AmazingSpanoMan/Gremlin_Gamepad/Gremlin_v3/CAD_Files/switch-joycon-joystick-1/Switch JoyCon joystick.jpg

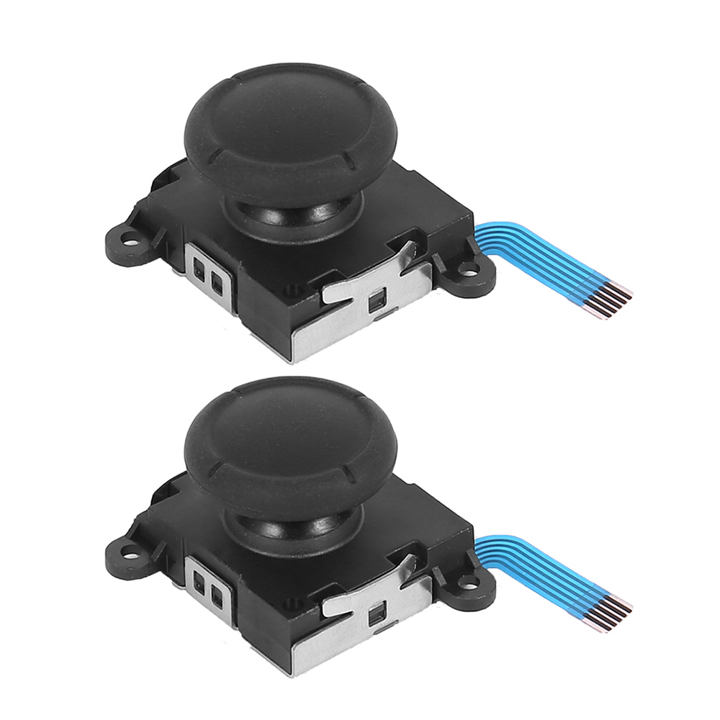
Gremlin_v3/CAD_Files/switch-joycon-joystick-1/Switch JoyCon joystick.jpg
