AmazingSpanoMan/Gremlin_Gamepad/Gremlin_v3/KiCad/Gemini_Generated_Image_chgj80chgj80chgj.jpg

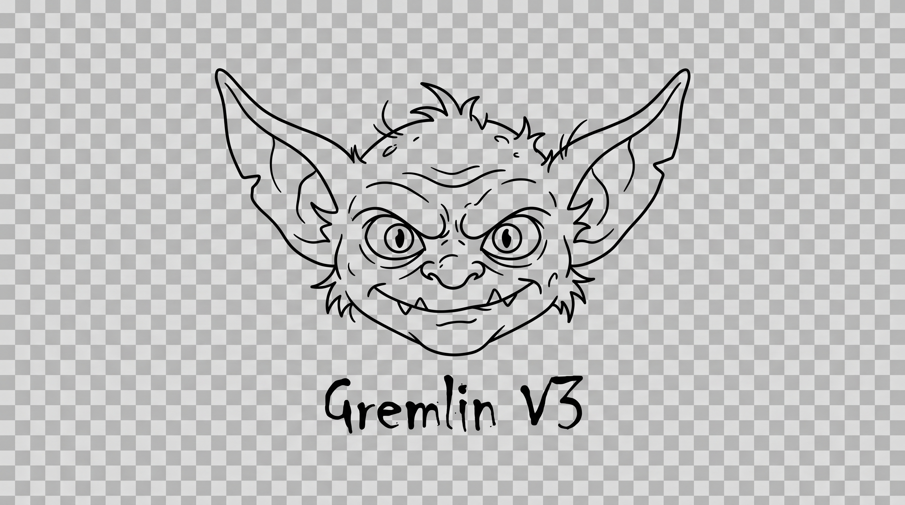
Gremlin_v3/KiCad/Gemini_Generated_Image_chgj80chgj80chgj.jpg
