AmazingSpanoMan/Gremlin_Gamepad/Gremlin_v3/KiCad/Gremlin_v3/production/bom.csv

Designator | Footprint | Quantity | Value | LCSC Part #
D1, D10, D11, D12, D13, D14, D15, D16, D17, D18, D19, D2, D20, D21, D22, D3, D4, D5, D6, D7, D8, D9 | Diode_SOD-123 | 22 | Diode
J1 | JST_EH_S2B-EH_1x02_P2.50mm_Horizontal | 1 | JST_02
J2 | CONN_503480-0540_MOL | 1 | 5034800540
S1, S10, S11, S12, S13, S14, S15, S16, S17, S18, S19, S2, S20, S21, S22, S3, S4, S5, S6, S7, S8, S9 | Hotswap_Choc_V1 | 22 | Keyswitch
SW1 | Panasonic_EVQPUJ_EVQPUA | 1 | Switch
SW2 | SW_SPDT_PCM12 | 1 | SW_SPST
U1 | Nice_Nano_V2 | 1 | Nice_Nano_V2
