AmazingSpanoMan/Gremlin_Gamepad/Gremlin_v3/CAD_Files/ScottoCaps/Flat/Blanks/2.75u.step

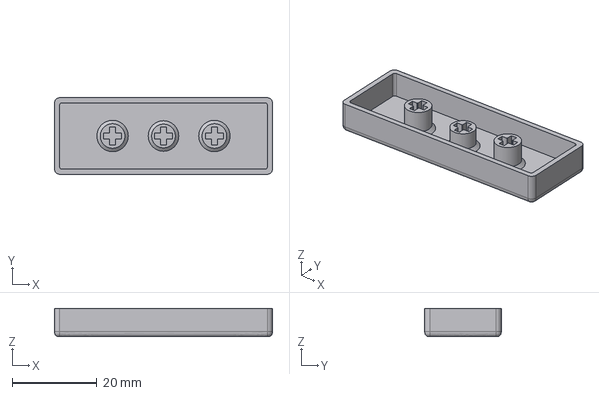
[picture p4: CAD file, 2026-10-09]
Gremlin_v3/CAD_Files/ScottoCaps/Flat/Blanks/2.75u.step
51.4 x 18.0 x 6.70 mm
