AmazingSpanoMan/Gremlin_Gamepad/Gremlin_v3/CAD_Files/ScottoCaps/Flat/Legends/Y.3mf

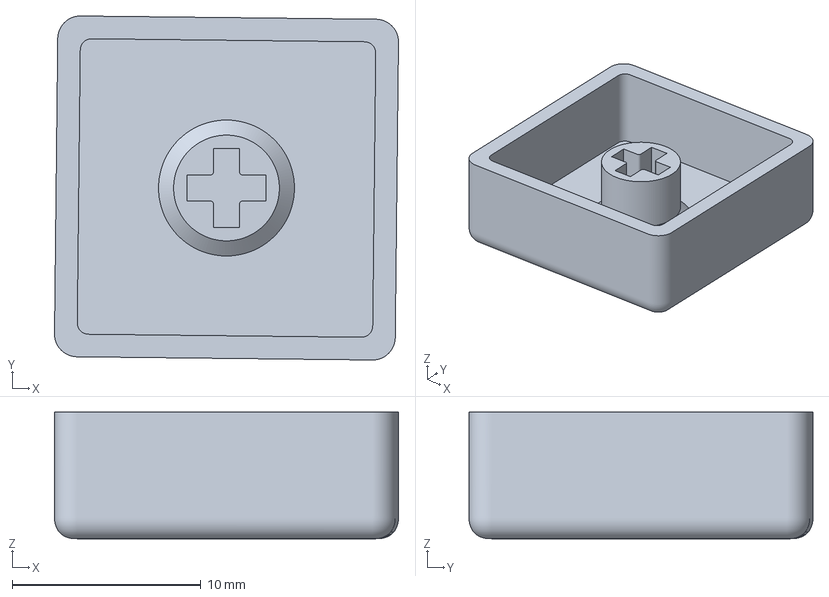
[picture p5: CAD file, 2026-10-09]
Gremlin_v3/CAD_Files/ScottoCaps/Flat/Legends/Y.3mf
18.2 x 18.2 x 6.70 mm
Y_Keycap
Y_Text
