AmazingSpanoMan/Gremlin_Gamepad/Gremlin_v3/CAD_Files/ScottoCaps/Flat/ScottoCaps (Flat).step

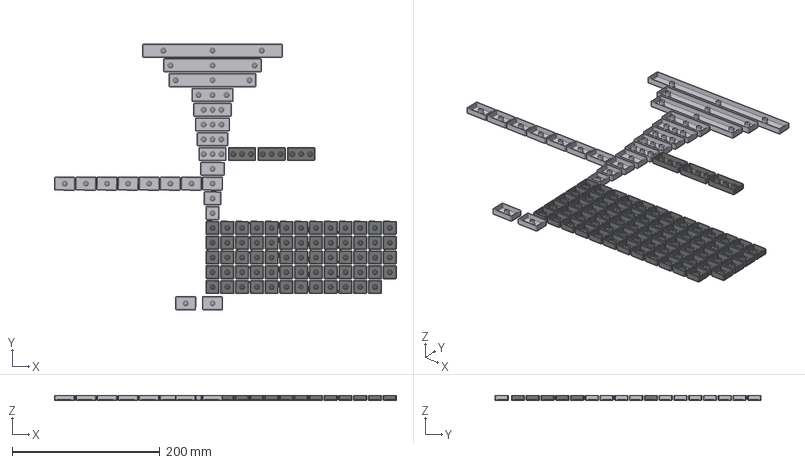
[picture p6: CAD file, 2026-10-09]
Gremlin_v3/CAD_Files/ScottoCaps/Flat/ScottoCaps (Flat).step
463.0 x 360.2 x 6.70 mm
Windows (1.50u)
Delete (1.50u)
Tab (1.50u)
Shift (1.50u)
Control (1.50u)
Alt (1.50u)
Caps Lock (1.50u)
No (1.50u)
Yes (1.50u)
Tilde
0 (2.00u)
Backspace
Tab
Q
W
F
P
G
J
L
U
Y
Semicolon
Slash
FSlash
Enter
Enter (2.00u)
A
R
S
T
D
H
N
E
I
O
Quote
LShift
Z
X
C
V
B
K
M
Less
Greater
Question
RShift
Hexagon1
Triangle1
Circle1
Square1
Hexagon2
Triangle2
Circle2
Square2
Left
Up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
