AmazingSpanoMan/Gremlin_Gamepad/Gremlin_v3/CAD_Files/ScottoCaps/Scooped/Choc/Blanks/16x16/1.25u (16x16 - Concave).step

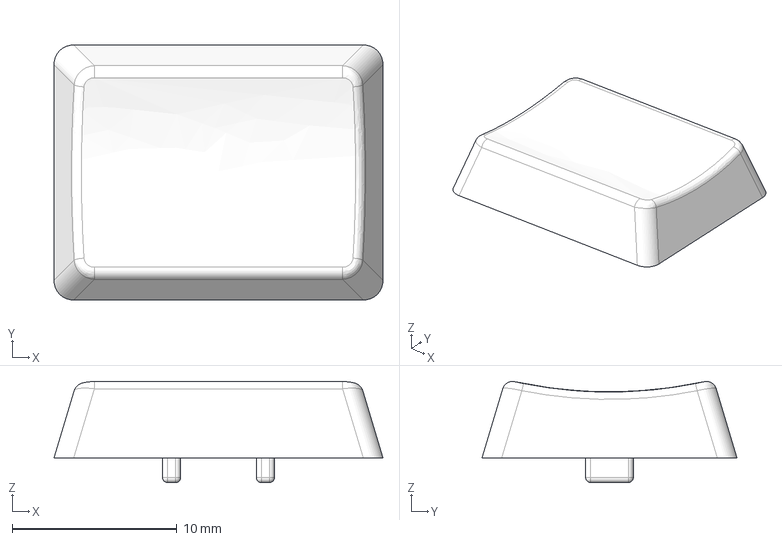
[picture p9: CAD file, 2026-10-09]
Gremlin_v3/CAD_Files/ScottoCaps/Scooped/Choc/Blanks/16x16/1.25u (16x16 - Concave).step
20.0 x 15.5 x 6.14 mm
