AmazingSpanoMan/Gremlin_Gamepad/Gremlin_v3/CAD_Files/ScottoCaps/Scooped/Choc/Blanks/18x17/1.75u (18x17 - Concave).step

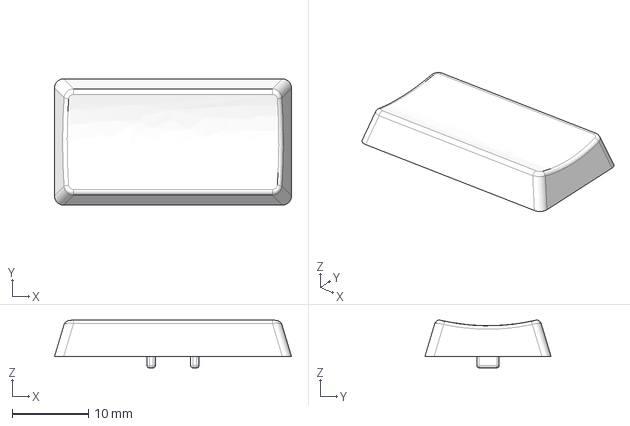
[picture p10: CAD file, 2026-10-09]
Gremlin_v3/CAD_Files/ScottoCaps/Scooped/Choc/Blanks/18x17/1.75u (18x17 - Concave).step
31.0 x 16.5 x 6.25 mm
