AmazingSpanoMan/Gremlin_Gamepad/Gremlin_v3/CAD_Files/ScottoCaps/Scooped/MX/Alphas.3mf

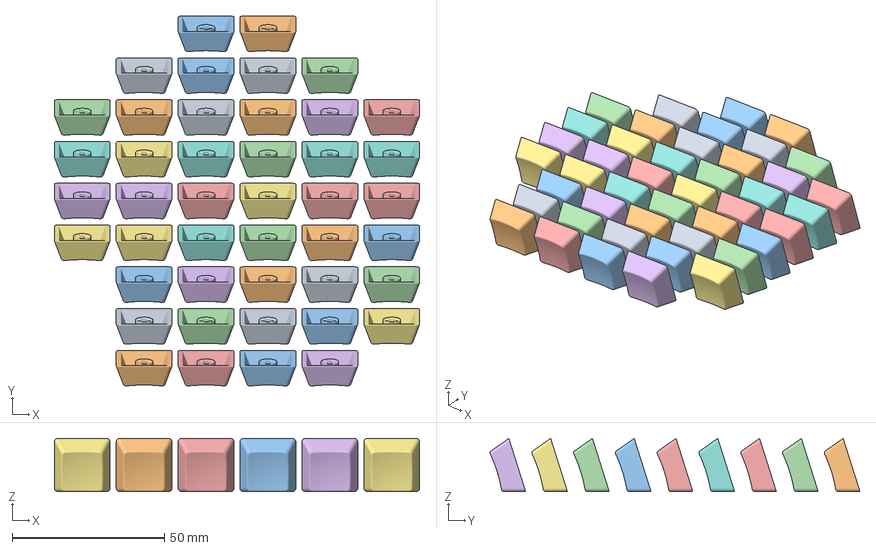
[picture p15: CAD file, 2026-10-09]
Gremlin_v3/CAD_Files/ScottoCaps/Scooped/MX/Alphas.3mf
119.8 x 121.3 x 17.5 mm
0 (1.00u)
Tilde
K
V
Angle Bracket x 2
D
O
Z
E
I
C
M
F (Homing Bar)
X
R
Y
J
S
B
U
P
N
F
H
Q
T
N (Homing Bar)
J (Homing Bar)
T (Homing Bar)
G
L
Question Mark
A
W
