AmazingSpanoMan/Gremlin_Gamepad/Gremlin_v3/CAD_Files/ScottoCaps/Scooped/MX/Blanks/2.75u (Concave).step

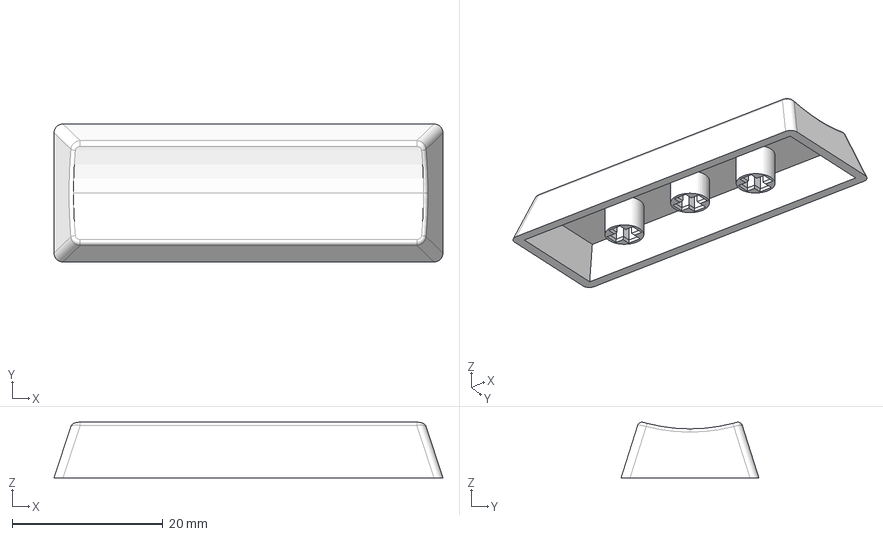
[picture p16: CAD file, 2026-10-09]
Gremlin_v3/CAD_Files/ScottoCaps/Scooped/MX/Blanks/2.75u (Concave).step
51.6 x 18.3 x 7.39 mm
