AmazingSpanoMan/Gremlin_Gamepad/Gremlin_v3/CAD_Files/ScottoCaps/Scooped/MX/Legends/Enter (1.00u).3mf

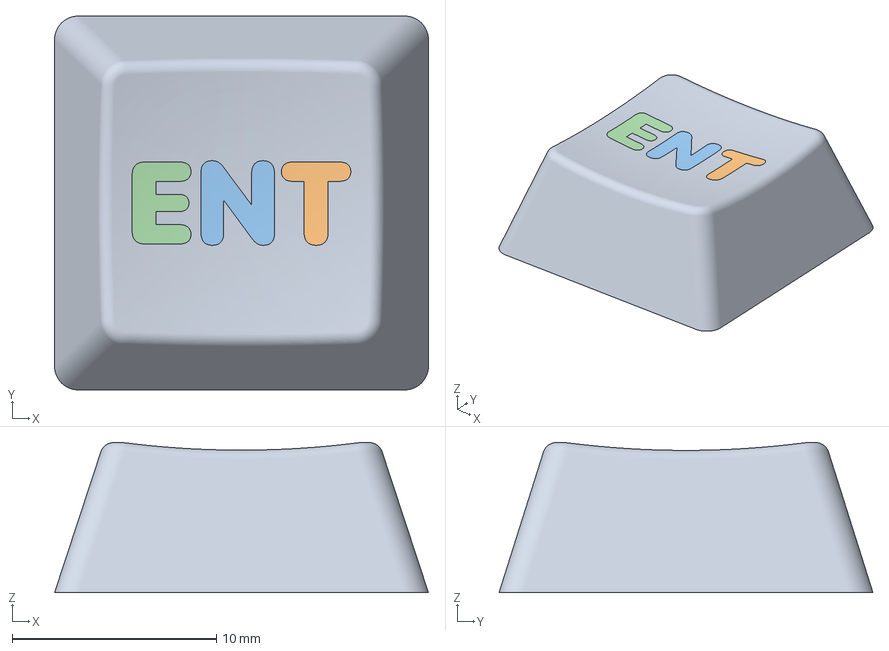
[picture p17: CAD file, 2026-10-09]
Gremlin_v3/CAD_Files/ScottoCaps/Scooped/MX/Legends/Enter (1.00u).3mf
18.3 x 18.3 x 7.36 mm
Keycap
T
N
E
