AmazingSpanoMan/Gremlin_Gamepad/Gremlin_v3/CAD_Files/ScottoCaps/Scooped/MX/Raw/Concave Cutter.step

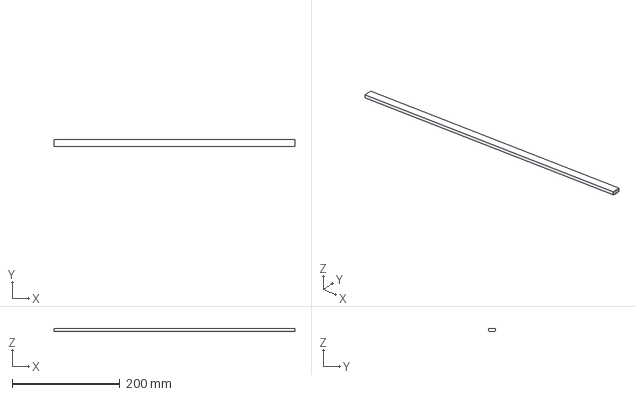
[picture p18: CAD file, 2026-10-09]
Gremlin_v3/CAD_Files/ScottoCaps/Scooped/MX/Raw/Concave Cutter.step
446.9 x 13.3 x 6.00 mm
