AmazingSpanoMan/Gremlin_Gamepad/Gremlin_v3/CAD_Files/ScottoCaps/Sculpted/Blanks/R3 - 2.00u.step

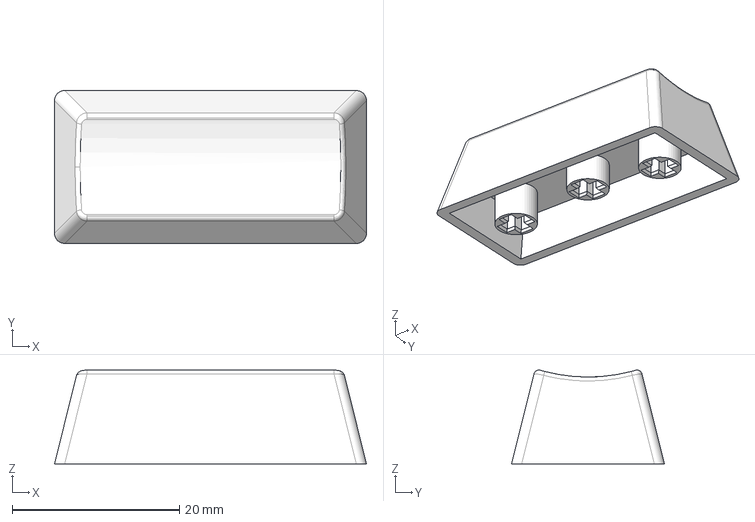
[picture p19: CAD file, 2026-10-09]
Gremlin_v3/CAD_Files/ScottoCaps/Sculpted/Blanks/R3 - 2.00u.step
37.4 x 18.3 x 11.2 mm
