AmazingSpanoMan/Gremlin_Gamepad/Gremlin_v3/CAD_Files/STL/Power Switch Button.stl

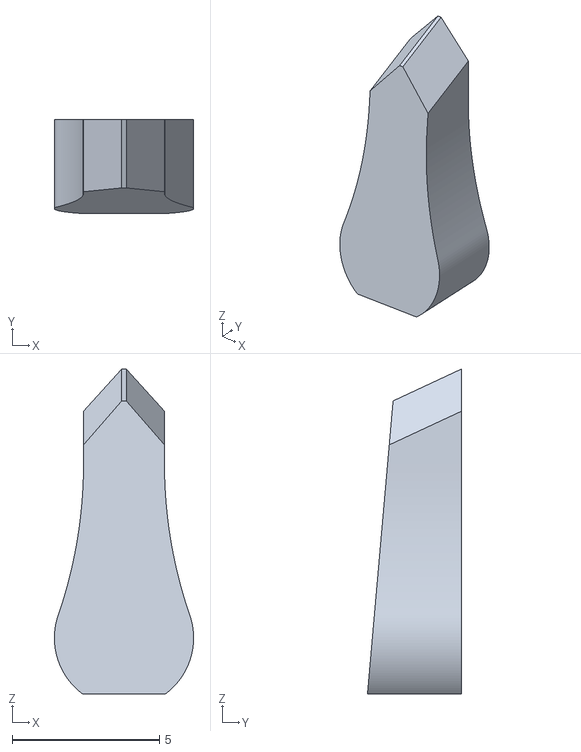
[picture p20: CAD file, 2026-11-13]
Gremlin_v3/CAD_Files/STL/Power Switch Button.stl
4.73 x 3.20 x 11.1
