AmazingSpanoMan/Gremlin_Gamepad/Gremlin_v3/CAD_Files/switch-joycon-joystick-1/Switch JoyCon joystick v2.step

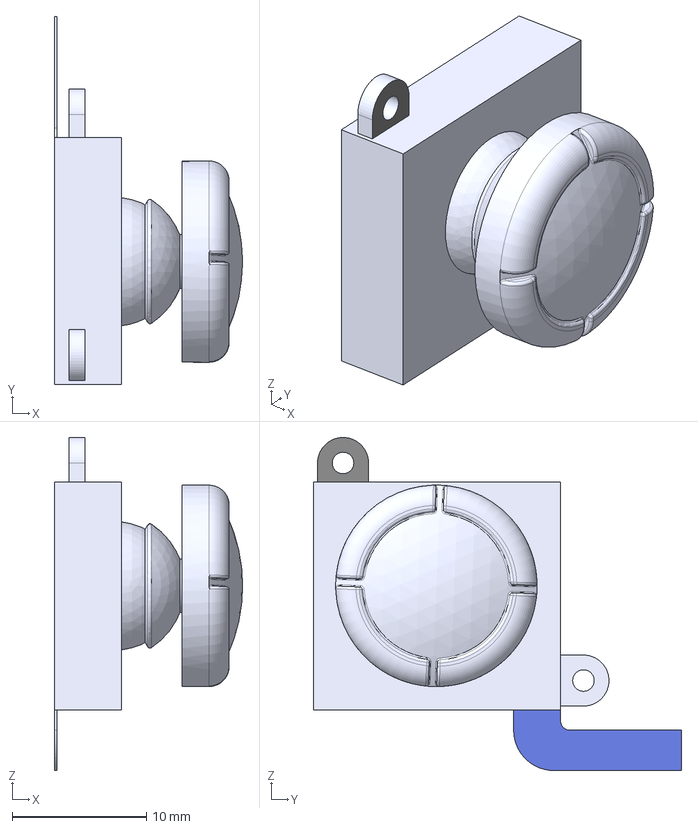
[picture p21: CAD file, 2026-10-09]
Gremlin_v3/CAD_Files/switch-joycon-joystick-1/Switch JoyCon joystick v2.step
14.0 x 27.4 x 24.8 mm
