AmazingSpanoMan/Gremlin_Gamepad/Gremlin_v3/KiCad/Footprint models/FPC-5.stp

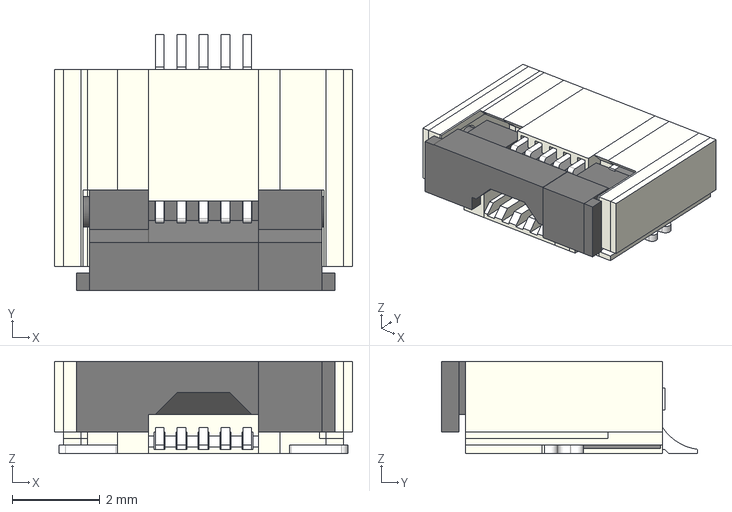
[picture p22: CAD file, 2026-10-09]
Gremlin_v3/KiCad/Footprint models/FPC-5.stp
6.80 x 5.85 x 2.11 mm
