AmazingSpanoMan/Gremlin_Gamepad/Gremlin_v3/KiCad/Gremlin_v3/Gremlin_v3_3.step

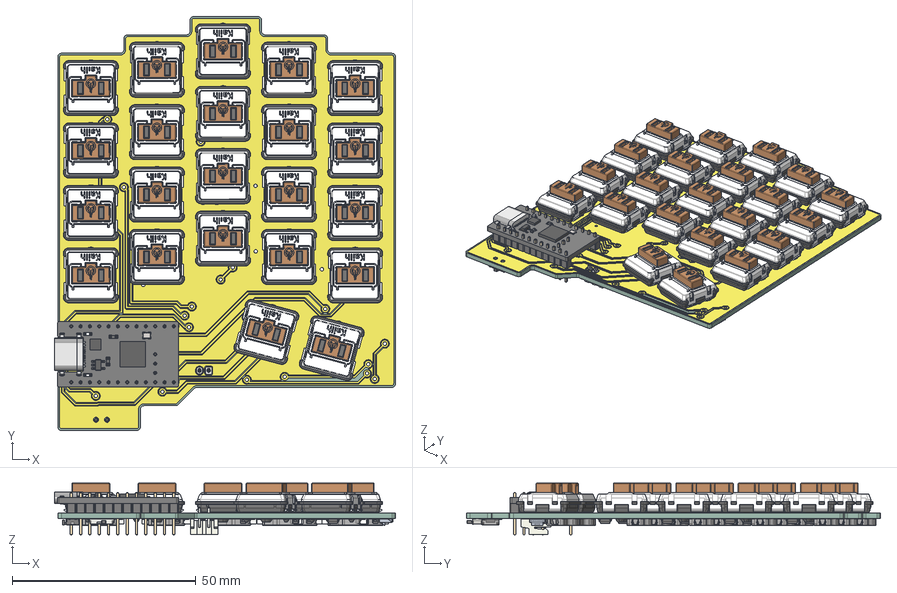
[picture p23: CAD file, 2026-10-23]
Gremlin_v3/KiCad/Gremlin_v3/Gremlin_v3_3.step
92.9 x 112.8 x 14.1 mm
SW_Hotswap_Kailh_Choc_v1 x 22
SW_Kailh_Choc_V1_cp x 22
PinHeader_1x12_P2.54mm_Vertical.step
User Library-TYPE-C-31-M-14.step
MICRO_603 resistor 102
MICRO_stackable header pin x 12
MICRO_stackable header 12
micro_crystal 5x3
MICRO_led
micro_MIC5219
D_SOD_123 x 22
Panasonic_EVQPUJ_EVQPUA
Fusion_sp
JST_S2B_EH
Gremlin_v3_copper
Gremlin_v3_pad
Gremlin_v3_via
Gremlin_v3_PCB
