AmazingSpanoMan/Gremlin_Gamepad/Gremlin_v3/CAD_Files/ScottoCaps/Flat/Blanks/2.00u.step

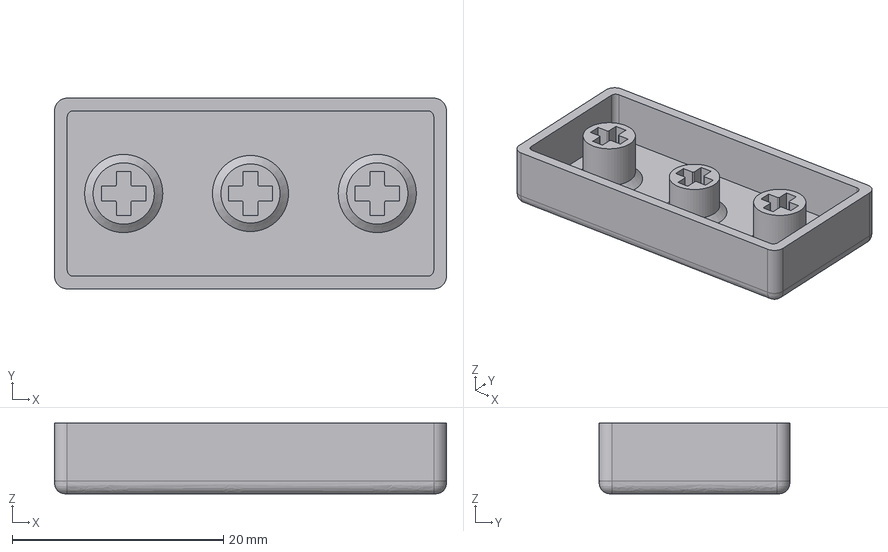
[picture p24: CAD file, 2026-10-09]
Gremlin_v3/CAD_Files/ScottoCaps/Flat/Blanks/2.00u.step
37.1 x 18.0 x 6.70 mm
