AmazingSpanoMan/Gremlin_Gamepad/Gremlin_v3/CAD_Files/ScottoCaps/Flat/Legends/Alt (1.50u).3mf

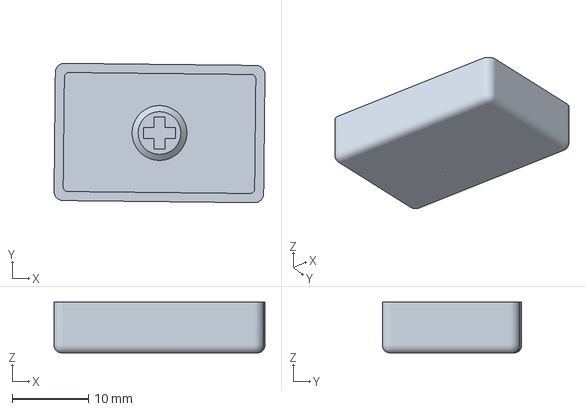
[picture p25: CAD file, 2026-10-09]
Gremlin_v3/CAD_Files/ScottoCaps/Flat/Legends/Alt (1.50u).3mf
27.7 x 18.3 x 6.70 mm
