AmazingSpanoMan/Gremlin_Gamepad/Gremlin_v3/CAD_Files/ScottoCaps/Glass/MX/ScottoCaps (Glass) - 2.00u.step

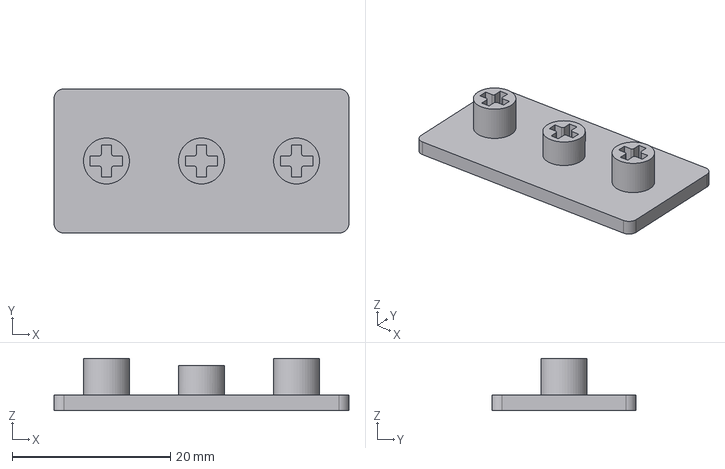
[picture p27: CAD file, 2026-10-09]
Gremlin_v3/CAD_Files/ScottoCaps/Glass/MX/ScottoCaps (Glass) - 2.00u.step
37.2 x 18.2 x 6.60 mm
