AmazingSpanoMan/Gremlin_Gamepad/Gremlin_v3/CAD_Files/ScottoCaps/Scooped/Choc/Blanks/16x16/1.50u (16x16 - Concave).step

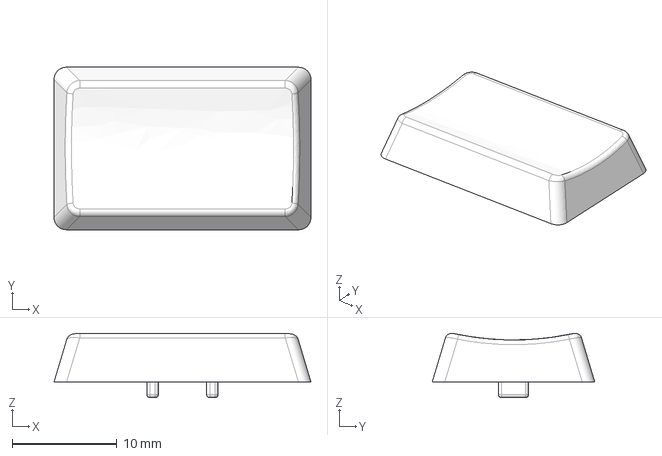
[picture p28: CAD file, 2026-10-09]
Gremlin_v3/CAD_Files/ScottoCaps/Scooped/Choc/Blanks/16x16/1.50u (16x16 - Concave).step
24.5 x 15.5 x 6.14 mm
