AmazingSpanoMan/Gremlin_Gamepad/Gremlin_v3/CAD_Files/ScottoCaps/Scooped/Choc/Blanks/18x18/1.00u (18x18 - Concave).step

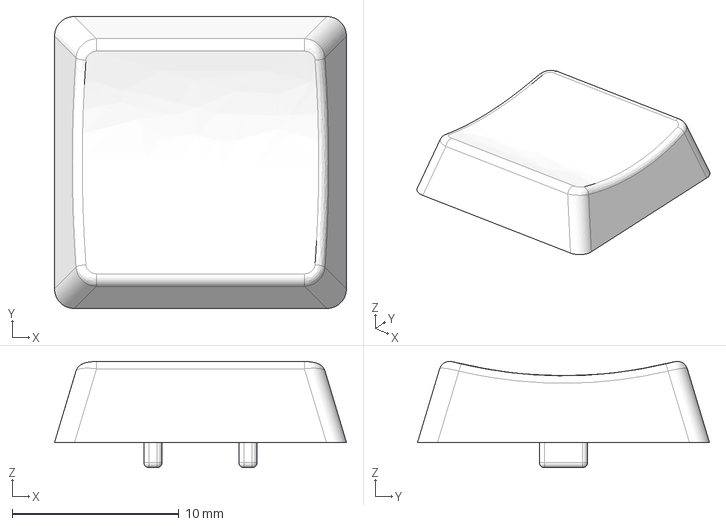
[picture p30: CAD file, 2026-10-09]
Gremlin_v3/CAD_Files/ScottoCaps/Scooped/Choc/Blanks/18x18/1.00u (18x18 - Concave).step
17.5 x 17.5 x 6.37 mm
