AmazingSpanoMan/Gremlin_Gamepad/Gremlin_v3/CAD_Files/ScottoCaps/Scooped/Choc/Legends/16x16/Arrow - Horizontal (16x16).3mf

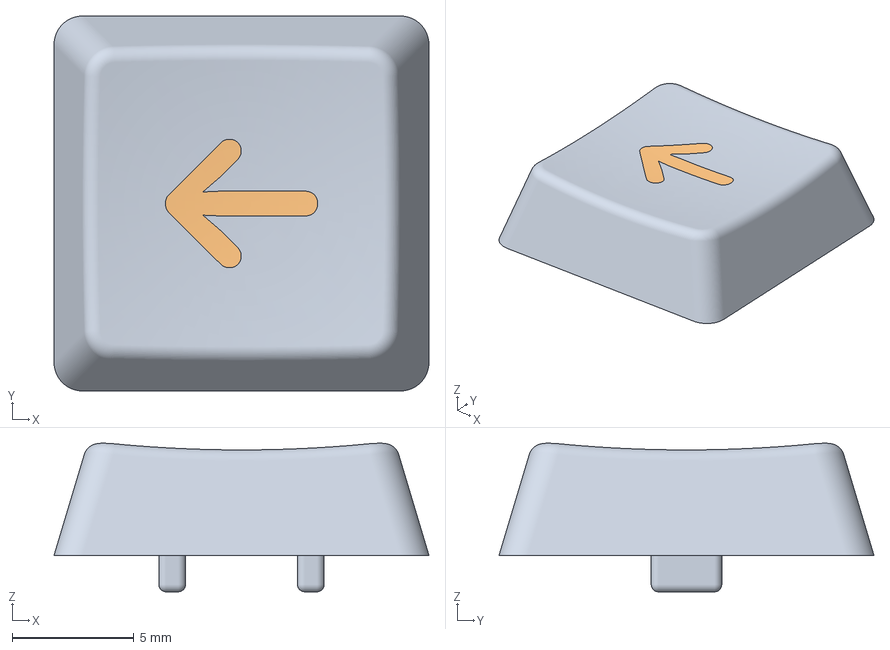
[picture p31: CAD file, 2026-10-09]
Gremlin_v3/CAD_Files/ScottoCaps/Scooped/Choc/Legends/16x16/Arrow - Horizontal (16x16).3mf
15.4 x 15.4 x 6.11 mm
Keycap
Legend
