AmazingSpanoMan/Gremlin_Gamepad/Gremlin_v3/CAD_Files/ScottoCaps/Scooped/MX/Blanks/6.25u (Concave).step

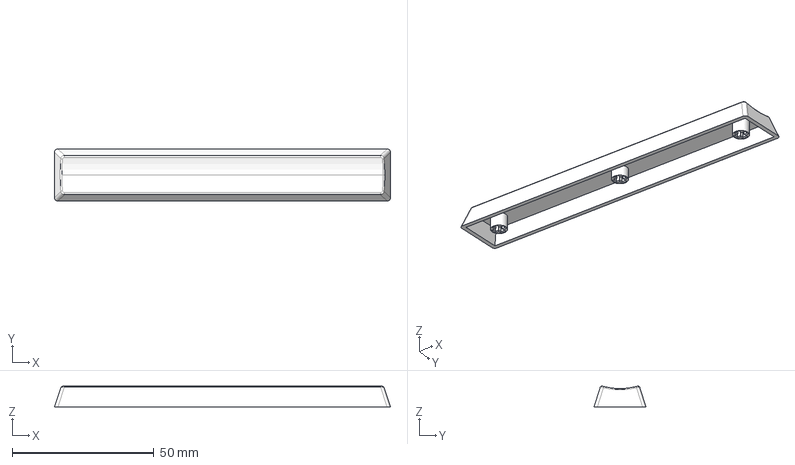
[picture p34: CAD file, 2026-10-09]
Gremlin_v3/CAD_Files/ScottoCaps/Scooped/MX/Blanks/6.25u (Concave).step
118.3 x 18.3 x 7.39 mm
