AmazingSpanoMan/Gremlin_Gamepad/Gremlin_v3/CAD_Files/ScottoCaps/Scooped/MX/Legends/Enter (2.25u).3mf

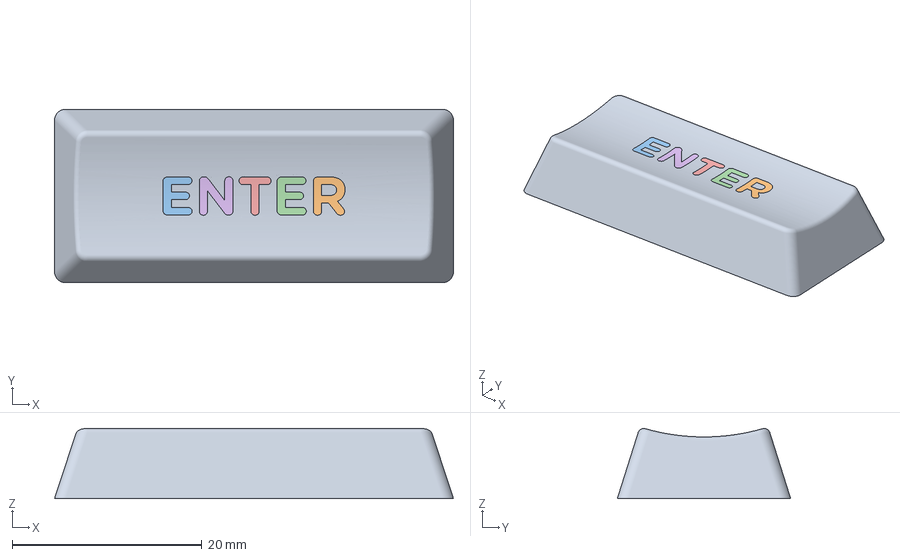
[picture p35: CAD file, 2026-10-09]
Gremlin_v3/CAD_Files/ScottoCaps/Scooped/MX/Legends/Enter (2.25u).3mf
42.1 x 18.3 x 7.39 mm
Keycap
R
E
E_(2)
T
N
