AmazingSpanoMan/Gremlin_Gamepad/Gremlin_v3/CAD_Files/ScottoCaps/Scooped/MX/Raw/7.00u (Raw).step

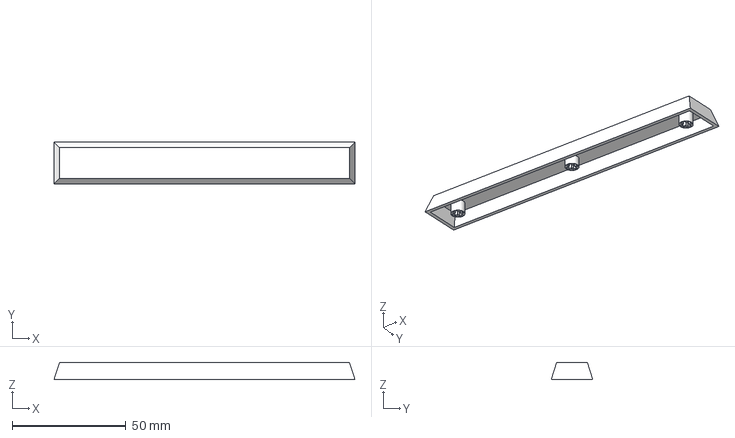
[picture p36: CAD file, 2026-10-09]
Gremlin_v3/CAD_Files/ScottoCaps/Scooped/MX/Raw/7.00u (Raw).step
132.6 x 18.3 x 7.50 mm
