AmazingSpanoMan/Gremlin_Gamepad/Gremlin_v3/CAD_Files/ScottoCaps/Scooped/MX/ScottoCaps (Scooped - MX) - Raw.step

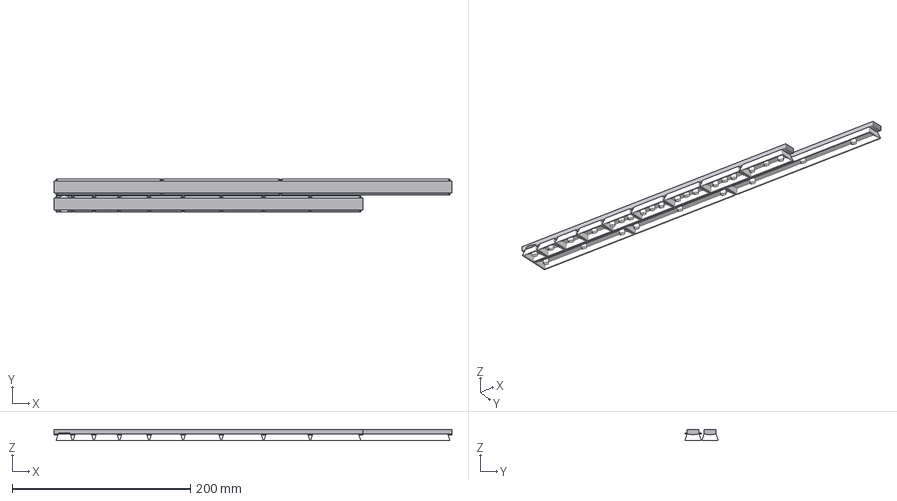
[picture p37: CAD file, 2026-10-09]
Gremlin_v3/CAD_Files/ScottoCaps/Scooped/MX/ScottoCaps (Scooped - MX) - Raw.step
446.9 x 37.5 x 12.5 mm
