AmazingSpanoMan/Gremlin_Gamepad/Gremlin_v3/CAD_Files/ScottoCaps/Sculpted/Blanks/R3 - 2.25u (Flat).step

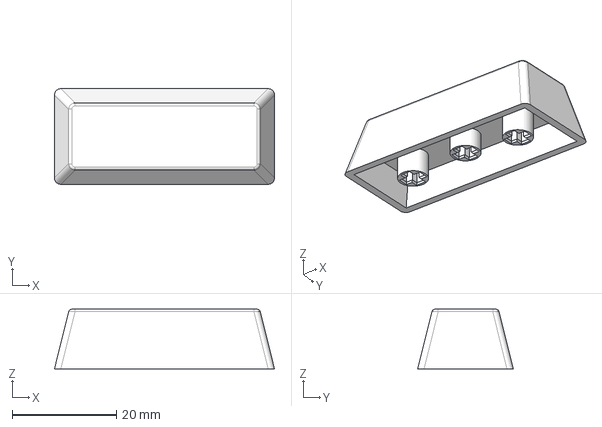
[picture p38: CAD file, 2026-10-09]
Gremlin_v3/CAD_Files/ScottoCaps/Sculpted/Blanks/R3 - 2.25u (Flat).step
42.1 x 18.3 x 11.4 mm
