AmazingSpanoMan/Gremlin_Gamepad/Gremlin_v3/CAD_Files/STL/Base.stl

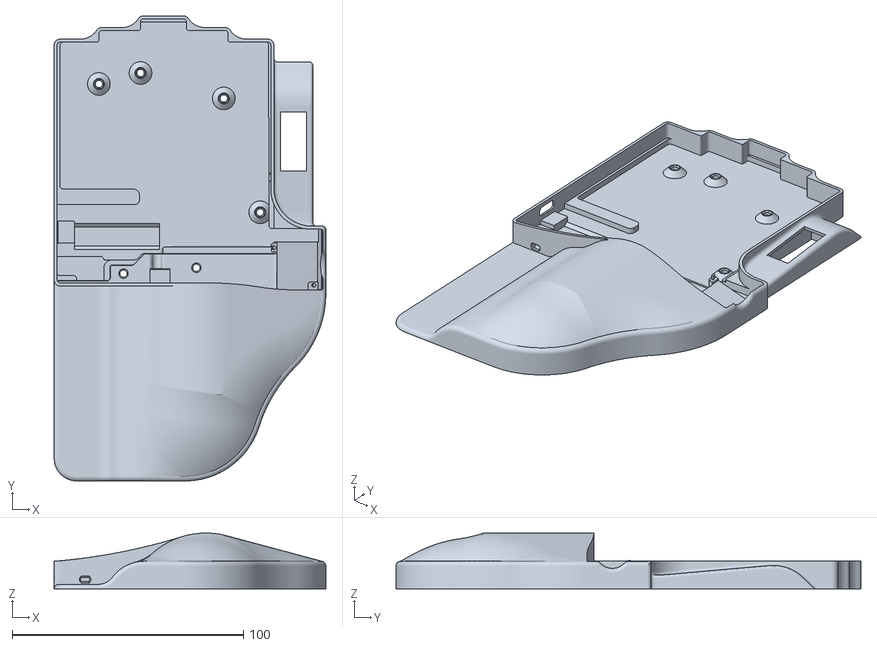
[picture p39: CAD file, 2026-11-10]
Gremlin_v3/CAD_Files/STL/Base.stl
117.5 x 201.1 x 24.2
