AmazingSpanoMan/Gremlin_Gamepad/Gremlin_v3/KiCad/Gremlin_v3/Gremlin_v3-Edge_Cuts.dxf

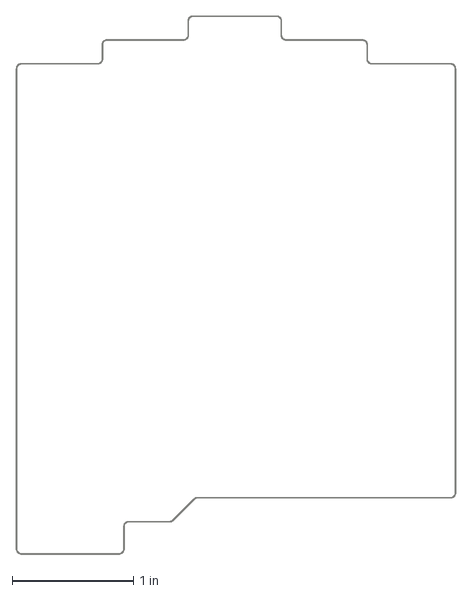
[picture p40: CAD file, 2026-10-20]
Gremlin_v3/KiCad/Gremlin_v3/Gremlin_v3-Edge_Cuts.dxf
3.62 x 4.44 in
