AmazingSpanoMan/Gremlin_Gamepad/Gremlin_v3/CAD_Files/ScottoCaps/Flat/Blanks/2.25u.step

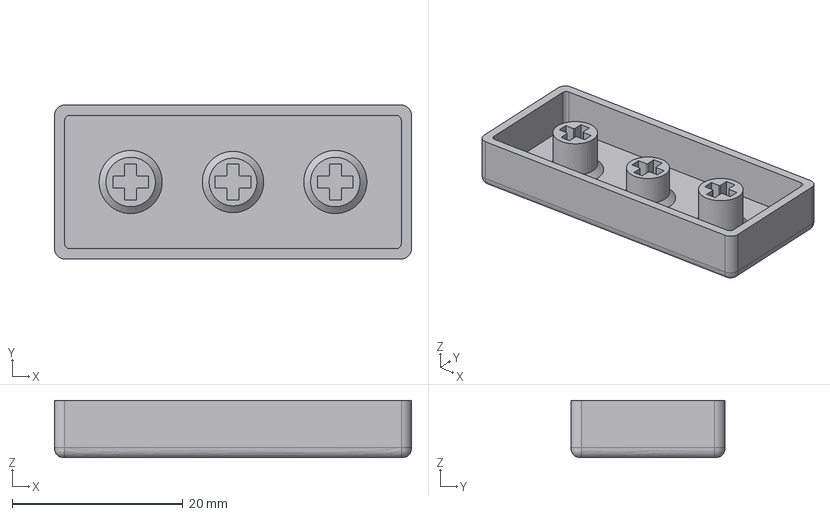
[picture p41: CAD file, 2026-10-09]
Gremlin_v3/CAD_Files/ScottoCaps/Flat/Blanks/2.25u.step
41.9 x 18.0 x 6.70 mm
