AmazingSpanoMan/Gremlin_Gamepad/Gremlin_v3/CAD_Files/ScottoCaps/Glass/Choc/ScottoCaps (Glass) - 1.25u.step

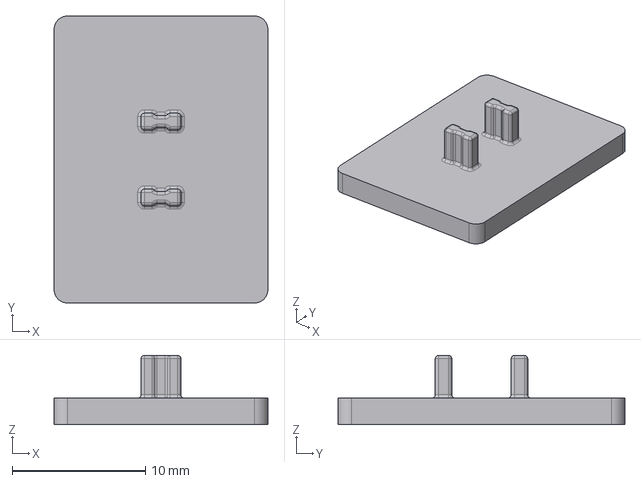
[picture p42: CAD file, 2026-10-09]
Gremlin_v3/CAD_Files/ScottoCaps/Glass/Choc/ScottoCaps (Glass) - 1.25u.step
16.1 x 21.5 x 5.20 mm
