AmazingSpanoMan/Gremlin_Gamepad/Gremlin_v3/CAD_Files/ScottoCaps/Glass/MX/ScottoCaps (Glass) - 2.25u.step

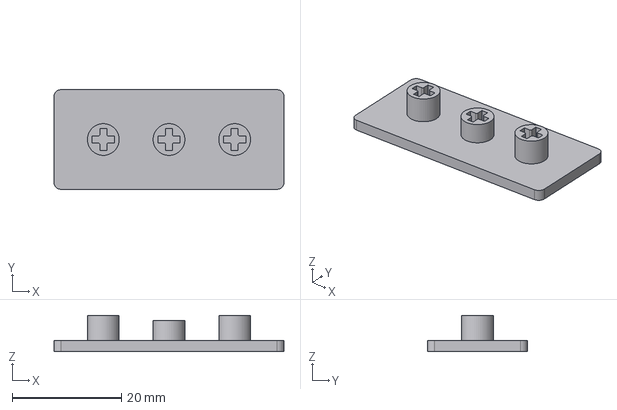
[picture p43: CAD file, 2026-10-09]
Gremlin_v3/CAD_Files/ScottoCaps/Glass/MX/ScottoCaps (Glass) - 2.25u.step
42.0 x 18.2 x 6.60 mm
