AmazingSpanoMan/Gremlin_Gamepad/Gremlin_v3/CAD_Files/ScottoCaps/Scooped/Choc/Blanks/18x17/1.00u (18x17 - Domed - Convex).step

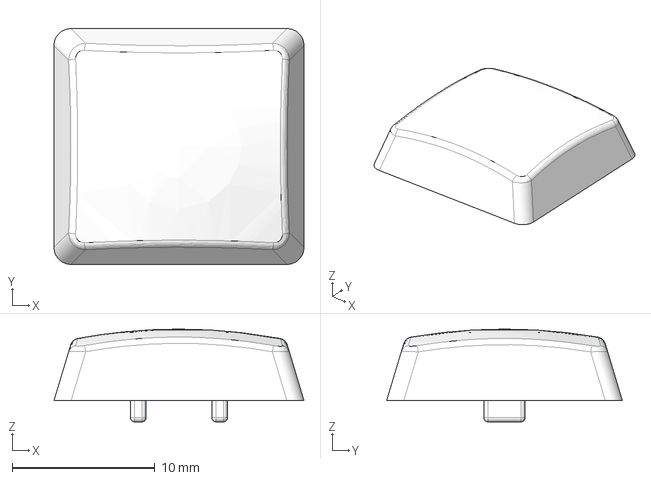
[picture p45: CAD file, 2026-10-09]
Gremlin_v3/CAD_Files/ScottoCaps/Scooped/Choc/Blanks/18x17/1.00u (18x17 - Domed - Convex).step
17.5 x 16.5 x 6.50 mm
