AmazingSpanoMan/Gremlin_Gamepad/Gremlin_v3/CAD_Files/ScottoCaps/Scooped/Choc/Legends/18x17/P (18x17).3mf

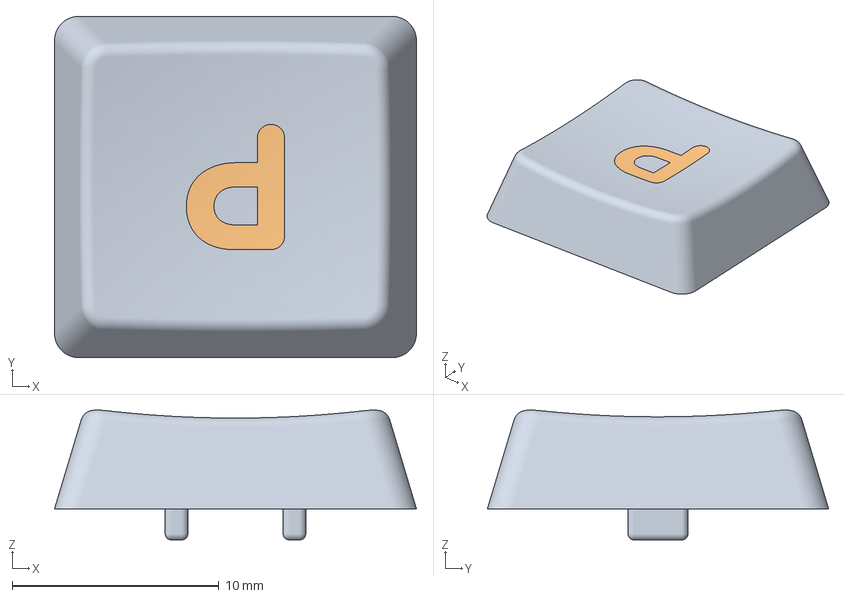
[picture p48: CAD file, 2026-10-09]
Gremlin_v3/CAD_Files/ScottoCaps/Scooped/Choc/Legends/18x17/P (18x17).3mf
17.5 x 16.5 x 6.28 mm
Keycap
Legend
