AmazingSpanoMan/Gremlin_Gamepad/Gremlin_v3/CAD_Files/ScottoCaps/Scooped/MX/Blanks/2.00u (Concave).step

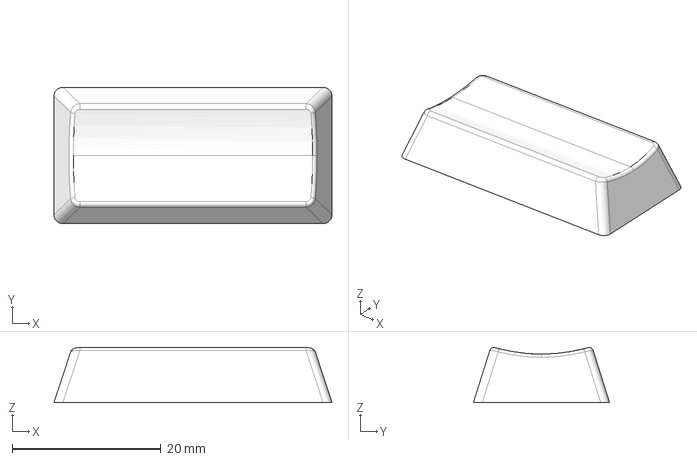
[picture p49: CAD file, 2026-10-09]
Gremlin_v3/CAD_Files/ScottoCaps/Scooped/MX/Blanks/2.00u (Concave).step
37.4 x 18.3 x 7.39 mm
