AmazingSpanoMan/Gremlin_Gamepad/Gremlin_v3/CAD_Files/ScottoCaps/Scooped/MX/Raw/6.25u (Raw).step

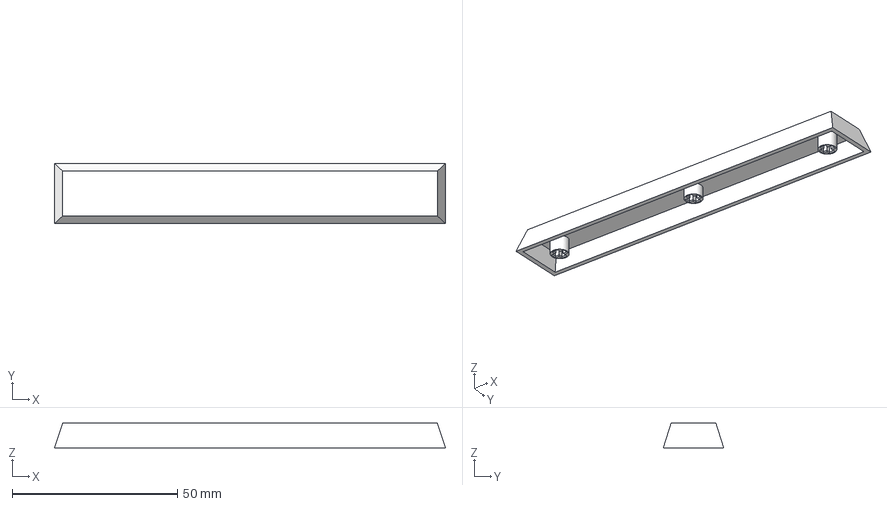
[picture p51: CAD file, 2026-10-09]
Gremlin_v3/CAD_Files/ScottoCaps/Scooped/MX/Raw/6.25u (Raw).step
118.3 x 18.3 x 7.50 mm
