AmazingSpanoMan/Gremlin_Gamepad/Gremlin_v3/CAD_Files/ScottoCaps/Sculpted/Blanks/R2- 10.00u.step

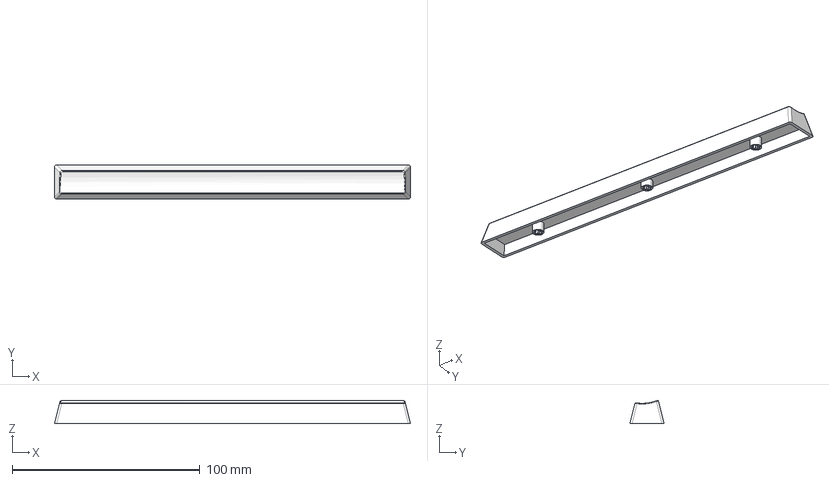
[picture p52: CAD file, 2026-10-09]
Gremlin_v3/CAD_Files/ScottoCaps/Sculpted/Blanks/R2- 10.00u.step
189.8 x 18.3 x 12.4 mm
