AmazingSpanoMan/Gremlin_Gamepad/Gremlin_v3/CAD_Files/STL/Top Plate.stl

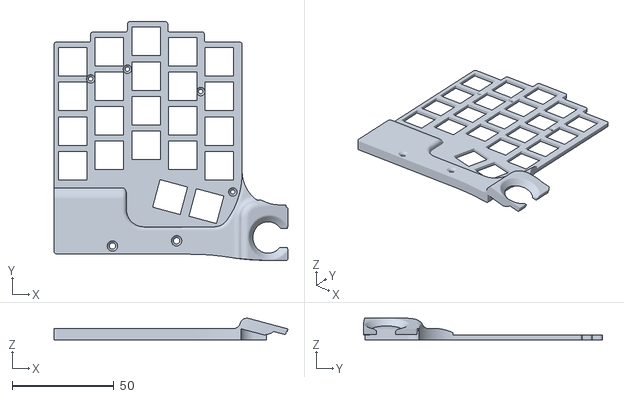
[picture p53: CAD file, 2026-10-29]
Gremlin_v3/CAD_Files/STL/Top Plate.stl
114.9 x 117.1 x 10.6
