AmazingSpanoMan/Gremlin_Gamepad/Gremlin_v3/CAD_Files/ScottoCaps/Flat/Blanks/10.00u.step

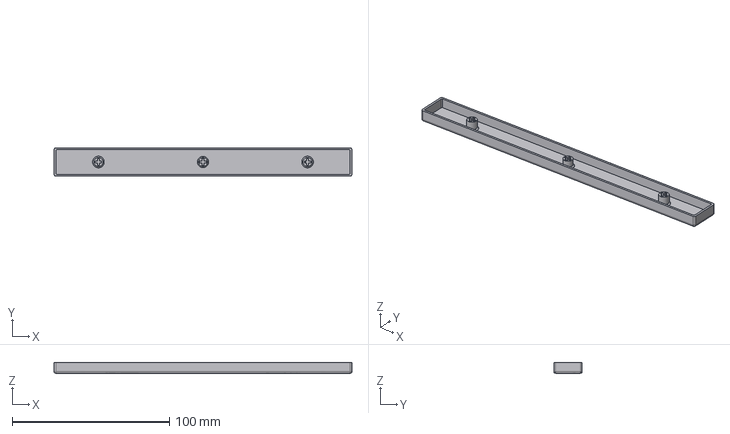
[picture p54: CAD file, 2026-10-09]
Gremlin_v3/CAD_Files/ScottoCaps/Flat/Blanks/10.00u.step
189.5 x 18.0 x 6.70 mm
