AmazingSpanoMan/Gremlin_Gamepad/Gremlin_v3/CAD_Files/ScottoCaps/Glass/Choc/ScottoCaps (Glass) - 1.50u.step

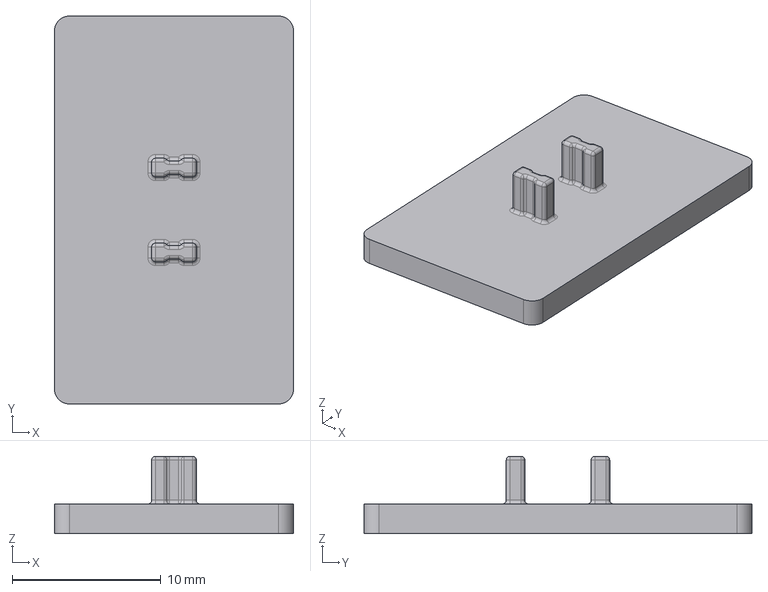
[picture p55: CAD file, 2026-10-09]
Gremlin_v3/CAD_Files/ScottoCaps/Glass/Choc/ScottoCaps (Glass) - 1.50u.step
16.1 x 26.0 x 5.20 mm
