AmazingSpanoMan/Gremlin_Gamepad/Gremlin_v3/CAD_Files/ScottoCaps/Glass/MX/ScottoCaps (Glass) - 1.25u.step

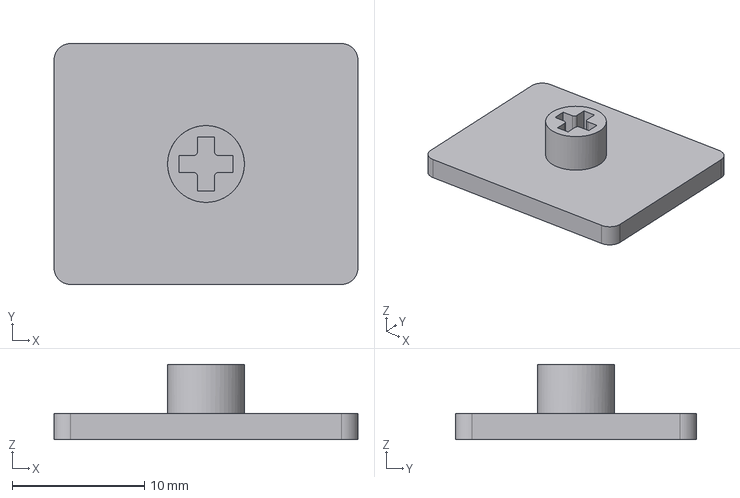
[picture p56: CAD file, 2026-10-09]
Gremlin_v3/CAD_Files/ScottoCaps/Glass/MX/ScottoCaps (Glass) - 1.25u.step
23.0 x 18.2 x 5.70 mm
