AmazingSpanoMan/Gremlin_Gamepad/Gremlin_v3/CAD_Files/ScottoCaps/Scooped/Choc/Blanks/18x17/1.00u (18x17 - Homing - Domed).step

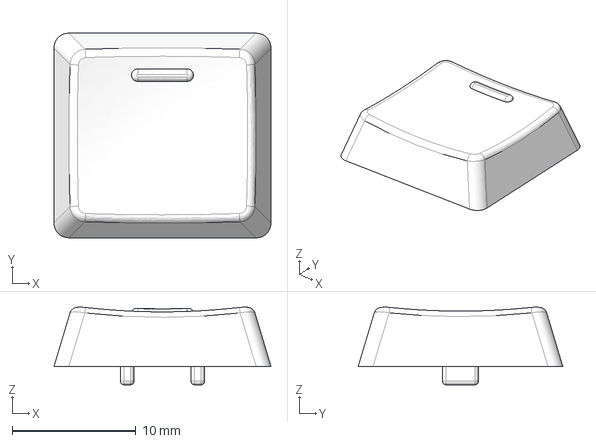
[picture p58: CAD file, 2026-10-09]
Gremlin_v3/CAD_Files/ScottoCaps/Scooped/Choc/Blanks/18x17/1.00u (18x17 - Homing - Domed).step
17.5 x 16.5 x 6.27 mm
