AmazingSpanoMan/Gremlin_Gamepad/Gremlin_v3/CAD_Files/ScottoCaps/Scooped/Choc/Blanks/18x18/1.50u (18x18 - Concave).step

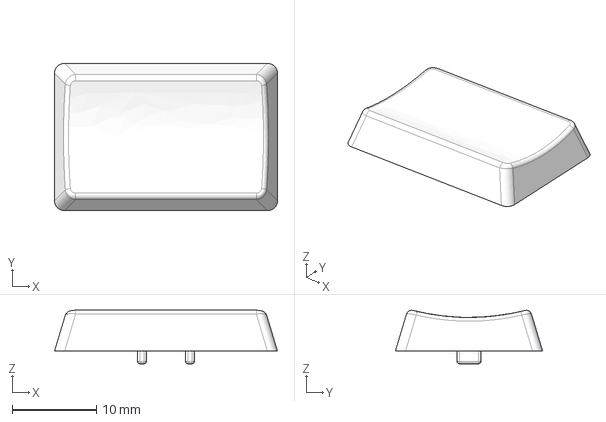
[picture p59: CAD file, 2026-10-09]
Gremlin_v3/CAD_Files/ScottoCaps/Scooped/Choc/Blanks/18x18/1.50u (18x18 - Concave).step
26.5 x 17.5 x 6.37 mm
