AmazingSpanoMan/Gremlin_Gamepad/Gremlin_v3/CAD_Files/ScottoCaps/Scooped/MX/Blanks/2x2 POS (Concave).step

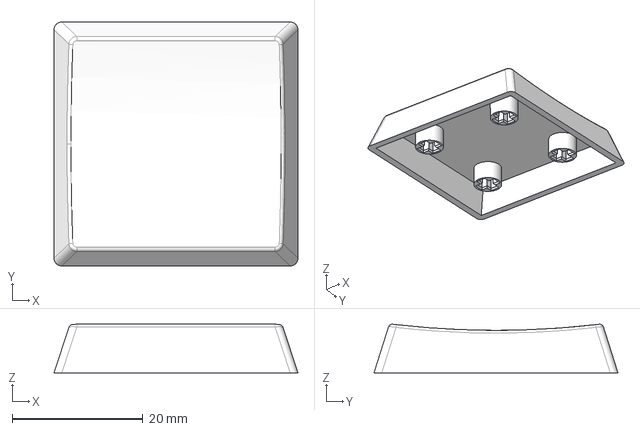
[picture p60: CAD file, 2026-10-09]
Gremlin_v3/CAD_Files/ScottoCaps/Scooped/MX/Blanks/2x2 POS (Concave).step
37.4 x 37.3 x 7.44 mm
