AmazingSpanoMan/Gremlin_Gamepad/Gremlin_v3/CAD_Files/ScottoCaps/Scooped/MX/Legends/0 (2.00u).3mf

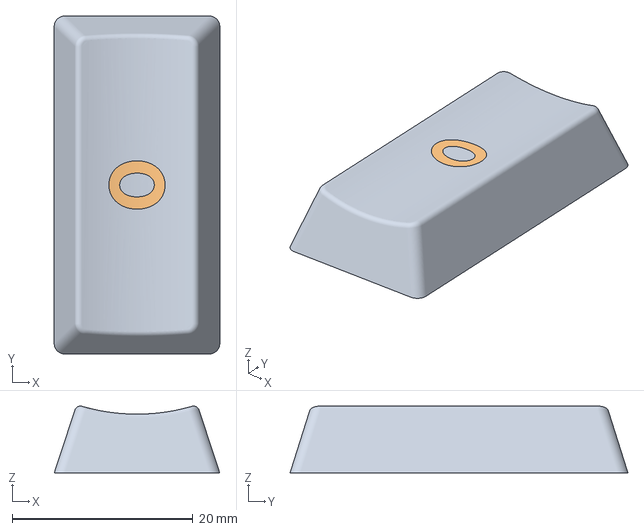
[picture p61: CAD file, 2026-10-09]
Gremlin_v3/CAD_Files/ScottoCaps/Scooped/MX/Legends/0 (2.00u).3mf
18.3 x 37.3 x 7.39 mm
Keycap
Legend
