AmazingSpanoMan/Gremlin_Gamepad/Gremlin_v3/CAD_Files/ScottoCaps/Scooped/MX/Raw/3.00u (Raw).step

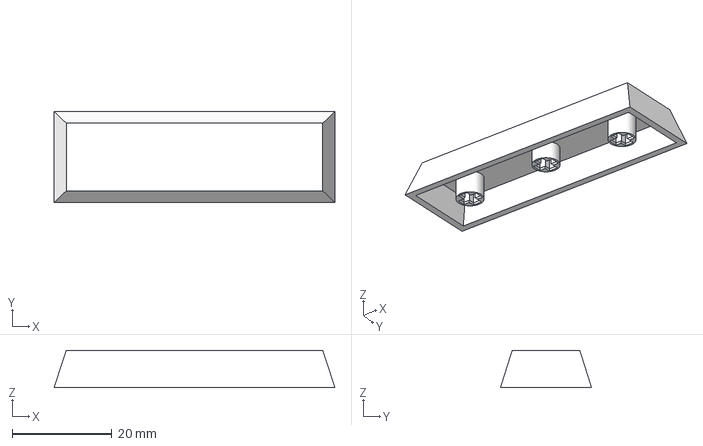
[picture p62: CAD file, 2026-10-09]
Gremlin_v3/CAD_Files/ScottoCaps/Scooped/MX/Raw/3.00u (Raw).step
56.4 x 18.3 x 7.50 mm
