AmazingSpanoMan/Gremlin_Gamepad/Gremlin_v3/CAD_Files/STL/Screen Cover.stl

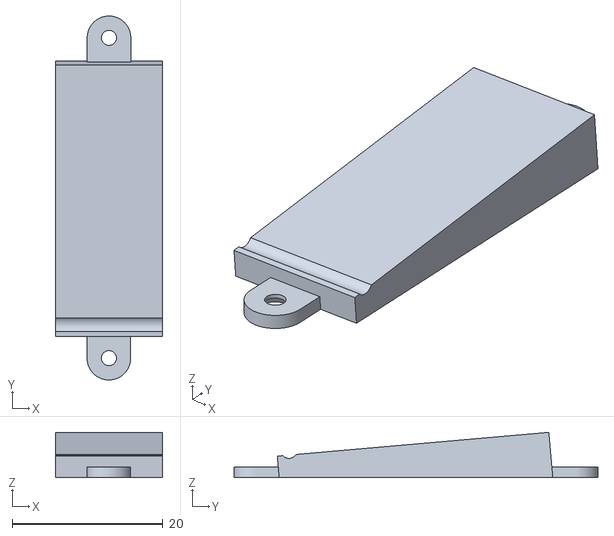
[picture p63: CAD file, 2026-10-28]
Gremlin_v3/CAD_Files/STL/Screen Cover.stl
14.2 x 48.3 x 6.02
