AmazingSpanoMan/Gremlin_Gamepad/Gremlin_v3/CAD_Files/ScottoCaps/Flat/Blanks/3.00u.step

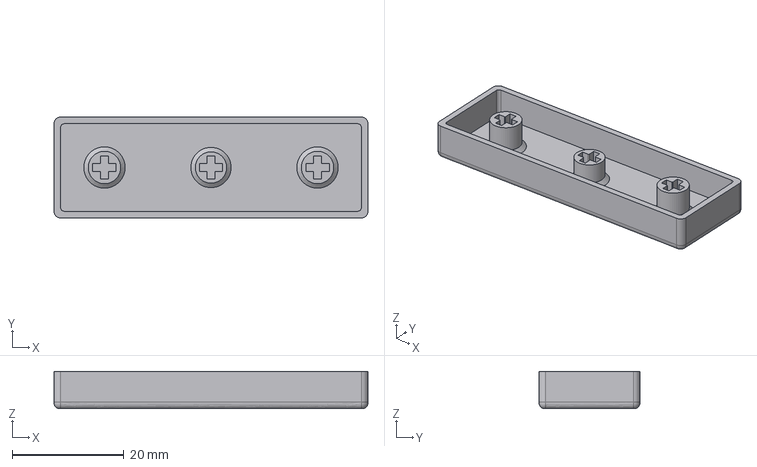
[picture p64: CAD file, 2026-10-09]
Gremlin_v3/CAD_Files/ScottoCaps/Flat/Blanks/3.00u.step
56.2 x 18.0 x 6.70 mm
