AmazingSpanoMan/Gremlin_Gamepad/Gremlin_v3/CAD_Files/ScottoCaps/Flat/Legends/Period.3mf

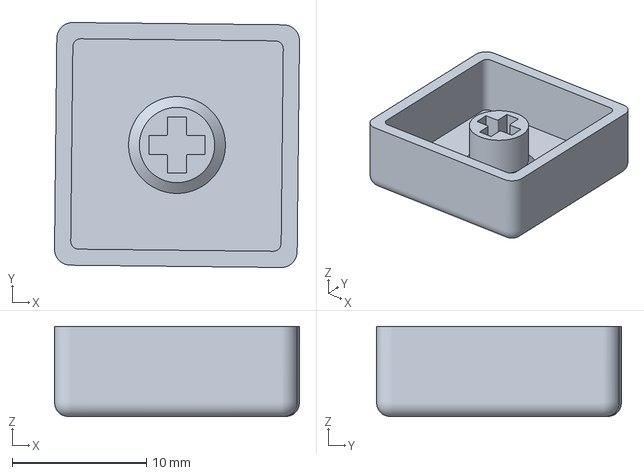
[picture p65: CAD file, 2026-10-09]
Gremlin_v3/CAD_Files/ScottoCaps/Flat/Legends/Period.3mf
18.2 x 18.2 x 6.70 mm
Period_Keycap
Period_Text
