AmazingSpanoMan/Gremlin_Gamepad/Gremlin_v3/CAD_Files/ScottoCaps/Glass/MX/ScottoCaps (Glass) - 1.00u.step

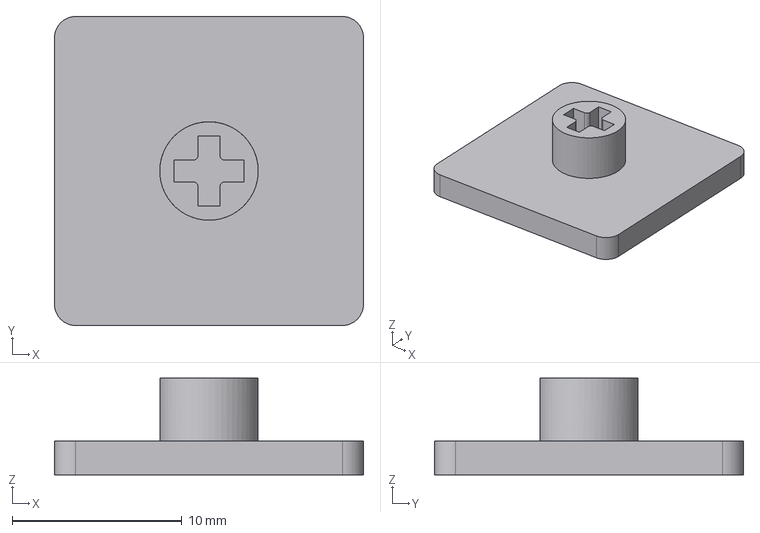
[picture p66: CAD file, 2026-10-09]
Gremlin_v3/CAD_Files/ScottoCaps/Glass/MX/ScottoCaps (Glass) - 1.00u.step
18.2 x 18.2 x 5.70 mm
