AmazingSpanoMan/Gremlin_Gamepad/Gremlin_v3/CAD_Files/ScottoCaps/Scooped/Choc/Blanks/16x16/1.75u (16x16 - Convex).step

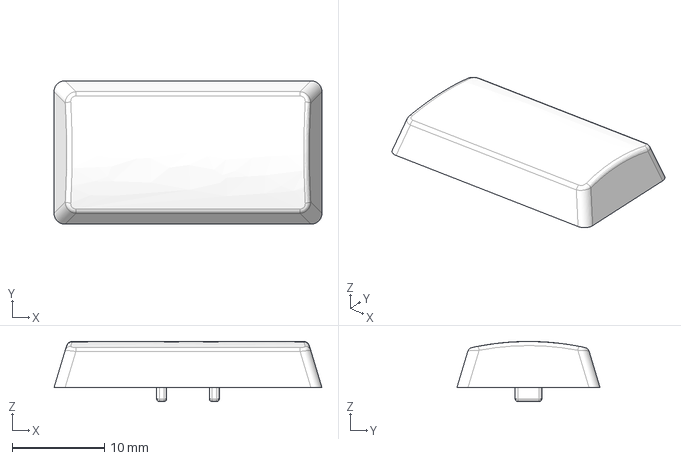
[picture p67: CAD file, 2026-10-09]
Gremlin_v3/CAD_Files/ScottoCaps/Scooped/Choc/Blanks/16x16/1.75u (16x16 - Convex).step
29.0 x 15.5 x 6.50 mm
