AmazingSpanoMan/Gremlin_Gamepad/Gremlin_v3/CAD_Files/ScottoCaps/Scooped/MX/Blanks/3.00u (Convex).step

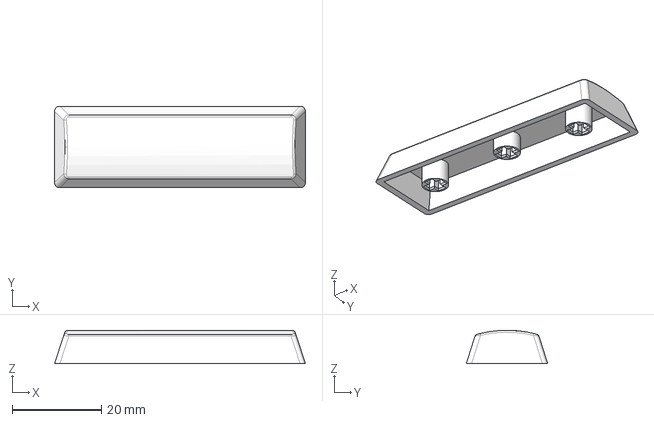
[picture p73: CAD file, 2026-10-09]
Gremlin_v3/CAD_Files/ScottoCaps/Scooped/MX/Blanks/3.00u (Convex).step
56.4 x 18.3 x 7.50 mm
