AmazingSpanoMan/Gremlin_Gamepad/Gremlin_v3/CAD_Files/ScottoCaps/Scooped/MX/Legends/Alt (1.25u).3mf

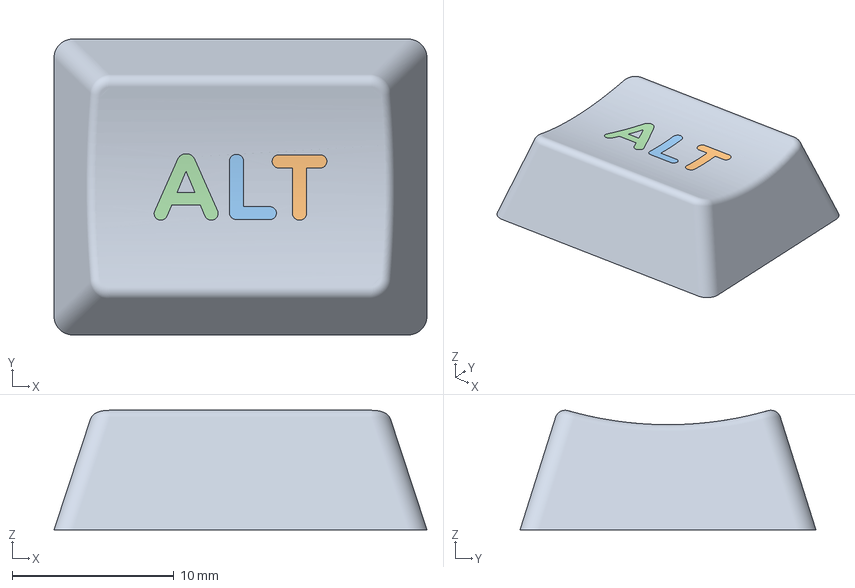
[picture p74: CAD file, 2026-10-09]
Gremlin_v3/CAD_Files/ScottoCaps/Scooped/MX/Legends/Alt (1.25u).3mf
23.1 x 18.3 x 7.39 mm
Keycap
T
L
A
