AmazingSpanoMan/Gremlin_Gamepad/Gremlin_v3/CAD_Files/ScottoCaps/Scooped/MX/Raw/2.50u (Raw).step

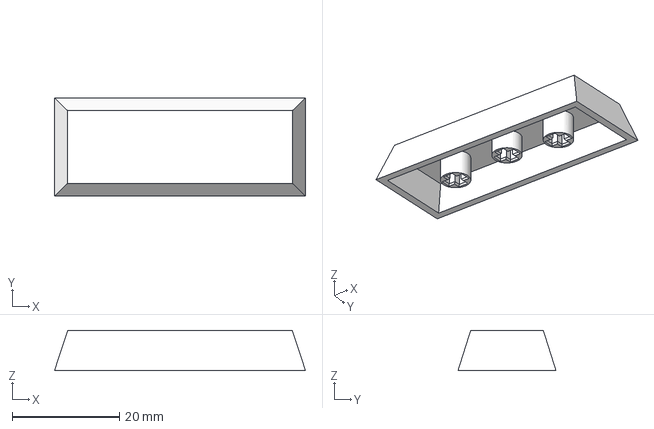
[picture p75: CAD file, 2026-10-09]
Gremlin_v3/CAD_Files/ScottoCaps/Scooped/MX/Raw/2.50u (Raw).step
46.9 x 18.3 x 7.50 mm
