AmazingSpanoMan/Gremlin_Gamepad/Gremlin_v3/CAD_Files/ScottoCaps/Sculpted/Blanks/R4 - 1.75u.step

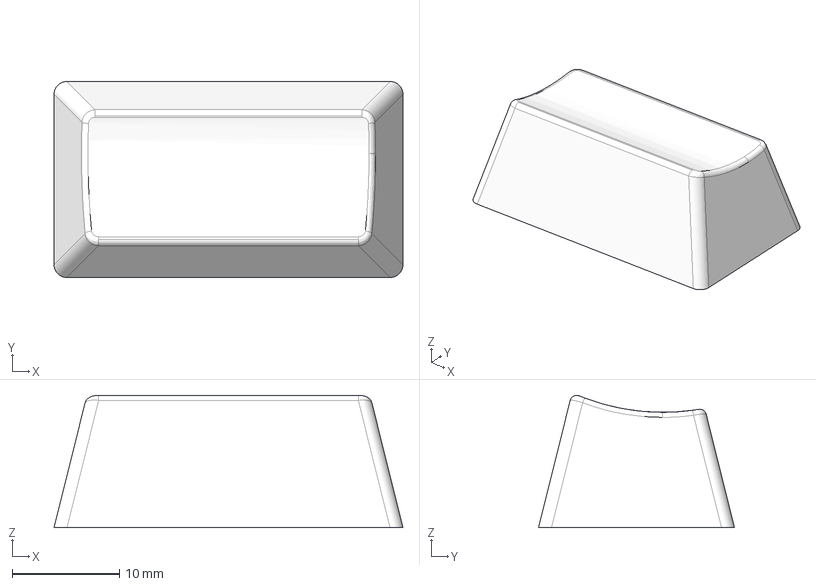
[picture p76: CAD file, 2026-10-09]
Gremlin_v3/CAD_Files/ScottoCaps/Sculpted/Blanks/R4 - 1.75u.step
32.6 x 18.3 x 12.4 mm
