AmazingSpanoMan/Gremlin_Gamepad/Gremlin_v3/CAD_Files/STL/Power Switch.stl

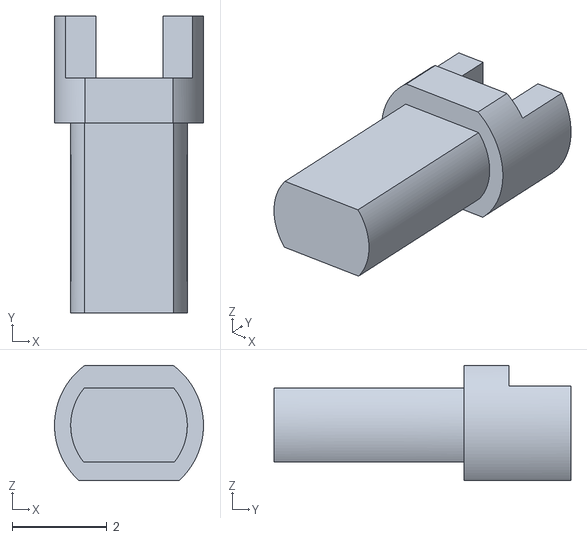
[picture p77: CAD file, 2026-10-28]
Gremlin_v3/CAD_Files/STL/Power Switch.stl
3.14 x 6.26 x 2.44
