AmazingSpanoMan/Gremlin_Gamepad/Gremlin_v3/CAD_Files/ScottoCaps/Scooped/Choc/Legends/16x16/J (16x16 - Homing).3mf

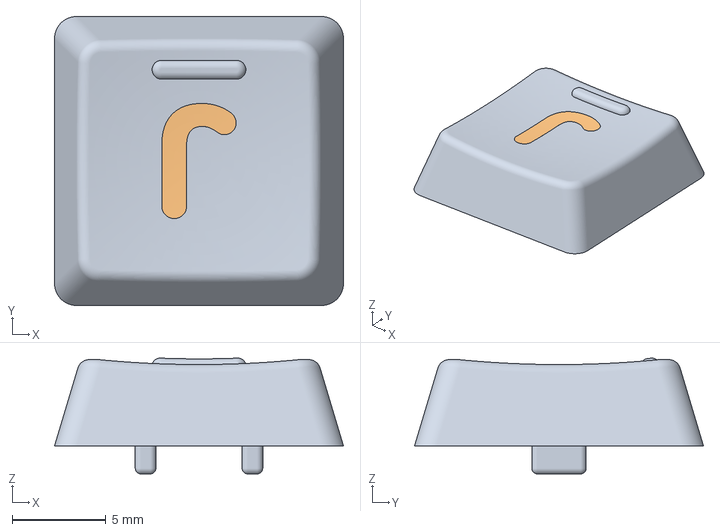
[picture p81: CAD file, 2026-10-09]
Gremlin_v3/CAD_Files/ScottoCaps/Scooped/Choc/Legends/16x16/J (16x16 - Homing).3mf
15.4 x 15.4 x 6.17 mm
Keycap
Legend
