AmazingSpanoMan/Gremlin_Gamepad/Gremlin_v3/CAD_Files/STL/Battery Cover.stl

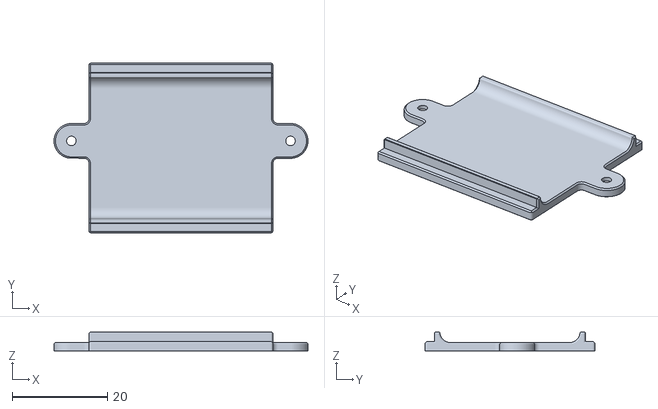
[picture p85: CAD file, 2026-10-28]
Gremlin_v3/CAD_Files/STL/Battery Cover.stl
53.3 x 35.6 x 3.98
