AmazingSpanoMan/Gremlin_Gamepad/Gremlin_v3/CAD_Files/ScottoCaps/Sculpted/Blanks/R3 - 1.75u (Sharp).step

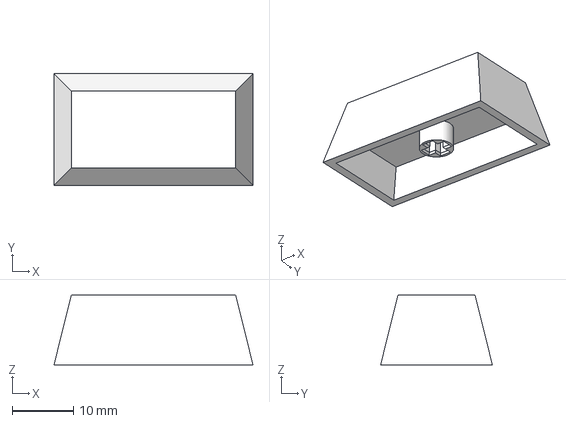
[picture p93: CAD file, 2026-10-09]
Gremlin_v3/CAD_Files/ScottoCaps/Sculpted/Blanks/R3 - 1.75u (Sharp).step
32.6 x 18.3 x 11.4 mm
