AmazingSpanoMan/Gremlin_Gamepad/Gremlin_v3/CAD_Files/ScottoCaps/Flat/Legends/Plus (2.00u).3mf

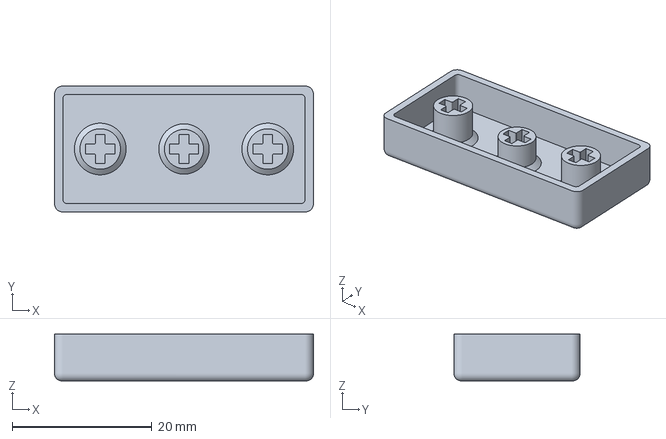
[picture p95: CAD file, 2026-10-09]
Gremlin_v3/CAD_Files/ScottoCaps/Flat/Legends/Plus (2.00u).3mf
37.1 x 18.0 x 6.70 mm
Plus_Keycap
Plus_Text
