AmazingSpanoMan/Gremlin_Gamepad/Gremlin_v3/CAD_Files/ScottoCaps/Scooped/Choc/Blanks/16x16/1.00u (16x16 - Homing - Concave).step

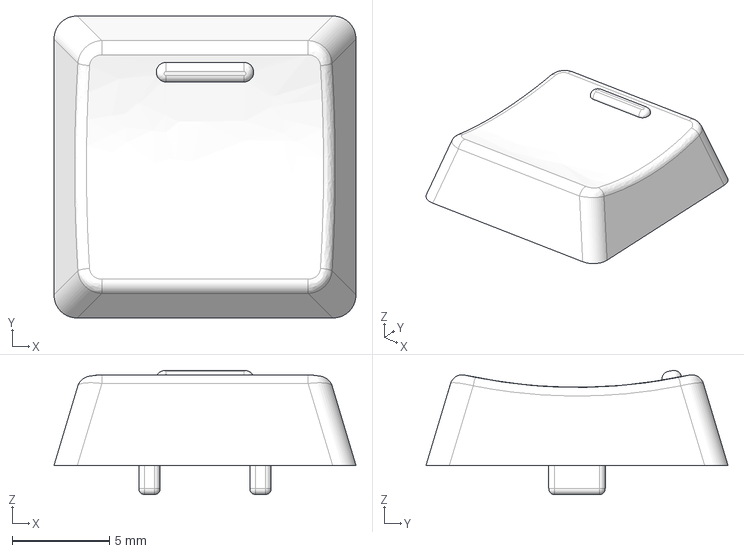
[picture p97: CAD file, 2026-10-09]
Gremlin_v3/CAD_Files/ScottoCaps/Scooped/Choc/Blanks/16x16/1.00u (16x16 - Homing - Concave).step
15.5 x 15.5 x 6.37 mm
