AmazingSpanoMan/Gremlin_Gamepad/Gremlin_v3/CAD_Files/ScottoCaps/Scooped/Choc/Legends/16x16/Option - Text (16x16).3mf

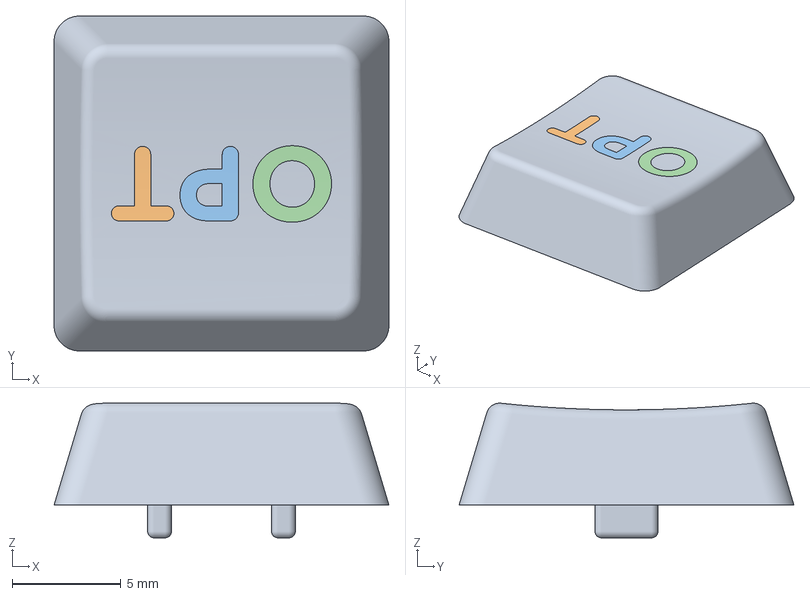
[picture p100: CAD file, 2026-10-09]
Gremlin_v3/CAD_Files/ScottoCaps/Scooped/Choc/Legends/16x16/Option - Text (16x16).3mf
15.4 x 15.4 x 6.20 mm
Keycap
T
P
O
