AmazingSpanoMan/Gremlin_Gamepad/Gremlin_v3/CAD_Files/ScottoCaps/Scooped/Choc/Legends/16x16/Caps Lock (16x16).3mf

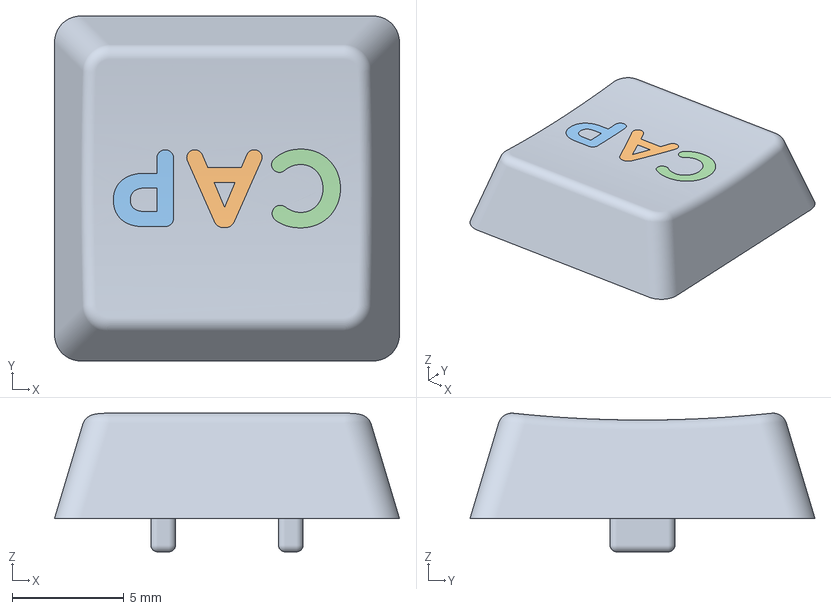
[picture p106: CAD file, 2026-10-09]
Gremlin_v3/CAD_Files/ScottoCaps/Scooped/Choc/Legends/16x16/Caps Lock (16x16).3mf
15.4 x 15.4 x 6.20 mm
Keycap
A_(1)
P_(1)
C_(1)
