AmazingSpanoMan/Gremlin_Gamepad/Gremlin_v3/CAD_Files/ScottoCaps/Flat/Legends/W.3mf

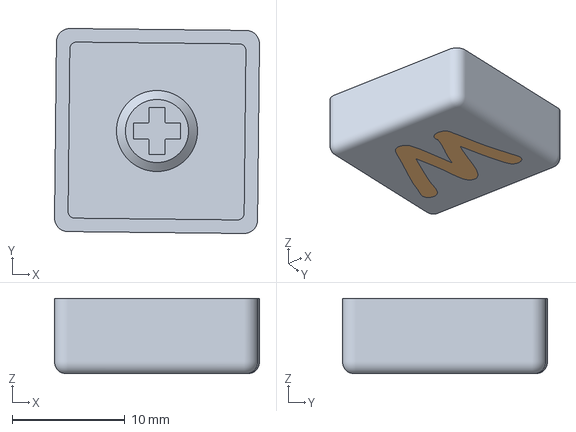
[picture p111: CAD file, 2026-10-09]
Gremlin_v3/CAD_Files/ScottoCaps/Flat/Legends/W.3mf
18.2 x 18.2 x 6.70 mm
W_Keycap
W_Text
