AmazingSpanoMan/Gremlin_Gamepad/Gremlin_v3/CAD_Files/ScottoCaps/Scooped/Choc/Legends/18x18/Command - Icon (18x18).3mf

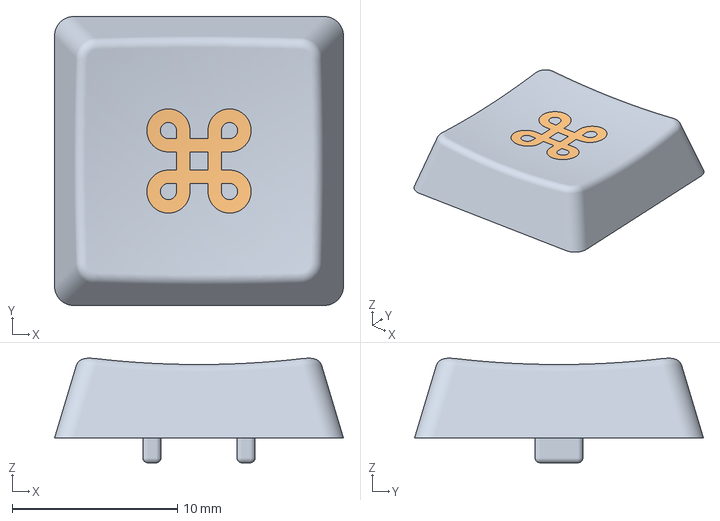
[picture p116: CAD file, 2026-10-09]
Gremlin_v3/CAD_Files/ScottoCaps/Scooped/Choc/Legends/18x18/Command - Icon (18x18).3mf
17.5 x 17.5 x 6.33 mm
Keycap
Legend
