AmazingSpanoMan/Gremlin_Gamepad/(list of files, cad)

Other CAD files:
Gremlin_v3/CAD_Files/ScottoCaps/Flat/Legends/I.3mf
Gremlin_v3/CAD_Files/ScottoCaps/Scooped/Choc/Legends/18x18/E (18x18).3mf
Gremlin_v3/CAD_Files/ScottoCaps/Flat/Legends/LShift.3mf
Gremlin_v3/CAD_Files/ScottoCaps/Scooped/Choc/Legends/16x16/Hexagon (16x16).3mf
Gremlin_v3/CAD_Files/ScottoCaps/Scooped/Choc/Legends/18x17/Period (18x17).3mf
Gremlin_v3/CAD_Files/ScottoCaps/Scooped/Choc/Legends/18x18/S (18x18).3mf
Gremlin_v3/CAD_Files/ScottoCaps/Sculpted/Blanks/R3 - 2.25u.step
Gremlin_v3/CAD_Files/ScottoCaps/Flat/Blanks/1.00u.step
Gremlin_v3/CAD_Files/ScottoCaps/Flat/Legends/F.3mf
Gremlin_v3/CAD_Files/ScottoCaps/Scooped/Choc/Blanks/18x17/1.00u (18x17 - Concave).step
Gremlin_v3/CAD_Files/ScottoCaps/Scooped/Choc/Legends/18x17/N (18x17).3mf
Gremlin_v3/CAD_Files/ScottoCaps/Scooped/Choc/Legends/18x18/Q (18x18).3mf
Gremlin_v3/CAD_Files/ScottoCaps/Scooped/MX/Legends/Question Mark.3mf
Gremlin_v3/CAD_Files/ScottoCaps/Flat/Legends/N.3mf
Gremlin_v3/CAD_Files/ScottoCaps/Scooped/Choc/Blanks/18x17/1.00u (18x17 - Domed - Concave).step
Gremlin_v3/CAD_Files/ScottoCaps/Scooped/Choc/Legends/18x17/Apostrophe (18x17).3mf
Gremlin_v3/CAD_Files/ScottoCaps/Scooped/Choc/Legends/18x18/R (18x18).3mf
Gremlin_v3/CAD_Files/ScottoCaps/Scooped/MX/Legends/Delete (1.00u).3mf
Gremlin_v3/CAD_Files/ScottoCaps/Scooped/Choc/Legends/18x17/M (18x17).3mf
Gremlin_v3/CAD_Files/ScottoCaps/Scooped/Choc/Legends/18x18/N (18x18).3mf
Gremlin_v3/CAD_Files/ScottoCaps/Scooped/MX/Blanks/10.00u (Convex).step
Gremlin_v3/CAD_Files/ScottoCaps/Scooped/MX/Legends/Function (1.00u).3mf
Gremlin_v3/CAD_Files/ScottoCaps/Flat/Legends/L.3mf
Gremlin_v3/CAD_Files/ScottoCaps/Scooped/Choc/Blanks/16x16/1.00u (16x16 - Concave).step
Gremlin_v3/CAD_Files/ScottoCaps/Scooped/Choc/Blanks/18x18/1.00u (18x18 - Homing - Domed).step
Gremlin_v3/CAD_Files/ScottoCaps/Scooped/Choc/Legends/18x18/U (18x18).3mf
Gremlin_v3/CAD_Files/ScottoCaps/Scooped/MX/Legends/Option (1.00u).3mf
Gremlin_v3/CAD_Files/ScottoCaps/Sculpted/Blanks/R3 - 10.00u (Flat).step
Gremlin_v3/CAD_Files/ScottoCaps/Scooped/Choc/Legends/16x16/H (16x16).3mf
Gremlin_v3/CAD_Files/ScottoCaps/Scooped/Choc/Legends/18x17/F (18x17 - Homing).3mf
Gremlin_v3/CAD_Files/ScottoCaps/Scooped/MX/Legends/Circle (Homing Bar).3mf
Gremlin_v3/CAD_Files/ScottoCaps/Sculpted/Blanks/R5 - 2.00u.step
Gremlin_v2/Design Files/ESwitch-JS1400AFQ/JS1400AFQ.step
Gremlin_v2/Design Files/ESwitch-JS5208/JS5208.step
Gremlin_v2/KiCad Files/Gremlin_v2.step
Gremlin_v2/KiCad Files/Joystick.step
Gremlin_v3/CAD_Files/ScottoCaps/Flat/Blanks/1.00u.3mf
Gremlin_v3/CAD_Files/ScottoCaps/Flat/Blanks/1.25u.3mf
Gremlin_v3/CAD_Files/ScottoCaps/Flat/Blanks/1.50u.3mf
Gremlin_v3/CAD_Files/ScottoCaps/Flat/Blanks/1.75u.3mf
Gremlin_v3/CAD_Files/ScottoCaps/Flat/Blanks/10.00u.3mf
Gremlin_v3/CAD_Files/ScottoCaps/Flat/Blanks/2.00u.3mf
Gremlin_v3/CAD_Files/ScottoCaps/Flat/Blanks/2.25u.3mf
Gremlin_v3/CAD_Files/ScottoCaps/Flat/Blanks/2.50u.3mf
Gremlin_v3/CAD_Files/ScottoCaps/Flat/Blanks/2.75u.3mf
Gremlin_v3/CAD_Files/ScottoCaps/Flat/Blanks/3.00u.3mf
Gremlin_v3/CAD_Files/ScottoCaps/Flat/Blanks/6.25u.3mf
Gremlin_v3/CAD_Files/ScottoCaps/Flat/Blanks/6.25u.step
Gremlin_v3/CAD_Files/ScottoCaps/Flat/Blanks/7.00u.3mf
Gremlin_v3/CAD_Files/ScottoCaps/Flat/Legends/0 (2.00u).3mf
Gremlin_v3/CAD_Files/ScottoCaps/Flat/Legends/0.3mf
Gremlin_v3/CAD_Files/ScottoCaps/Flat/Legends/1.3mf
Gremlin_v3/CAD_Files/ScottoCaps/Flat/Legends/2.3mf
Gremlin_v3/CAD_Files/ScottoCaps/Flat/Legends/3.3mf
Gremlin_v3/CAD_Files/ScottoCaps/Flat/Legends/4.3mf
Gremlin_v3/CAD_Files/ScottoCaps/Flat/Legends/5.3mf
Gremlin_v3/CAD_Files/ScottoCaps/Flat/Legends/6.3mf
Gremlin_v3/CAD_Files/ScottoCaps/Flat/Legends/7.3mf
Gremlin_v3/CAD_Files/ScottoCaps/Flat/Legends/8.3mf
Gremlin_v3/CAD_Files/ScottoCaps/Flat/Legends/9.3mf
Gremlin_v3/CAD_Files/ScottoCaps/Flat/Legends/A.3mf
Gremlin_v3/CAD_Files/ScottoCaps/Flat/Legends/Asterisk.3mf
Gremlin_v3/CAD_Files/ScottoCaps/Flat/Legends/B.3mf
Gremlin_v3/CAD_Files/ScottoCaps/Flat/Legends/Backspace.3mf
Gremlin_v3/CAD_Files/ScottoCaps/Flat/Legends/C.3mf
Gremlin_v3/CAD_Files/ScottoCaps/Flat/Legends/Caps Lock (1.50u).3mf
Gremlin_v3/CAD_Files/ScottoCaps/Flat/Legends/Circle.3mf
Gremlin_v3/CAD_Files/ScottoCaps/Flat/Legends/Control (1.50u).3mf
Gremlin_v3/CAD_Files/ScottoCaps/Flat/Legends/D.3mf
Gremlin_v3/CAD_Files/ScottoCaps/Flat/Legends/Delete (1.50u).3mf
Gremlin_v3/CAD_Files/ScottoCaps/Flat/Legends/Down.3mf
Gremlin_v3/CAD_Files/ScottoCaps/Flat/Legends/E.3mf
Gremlin_v3/CAD_Files/ScottoCaps/Flat/Legends/Enter (2.00u).3mf
Gremlin_v3/CAD_Files/ScottoCaps/Flat/Legends/Enter.3mf
Gremlin_v3/CAD_Files/ScottoCaps/Flat/Legends/FSlash.3mf
Gremlin_v3/CAD_Files/ScottoCaps/Flat/Legends/G.3mf
Gremlin_v3/CAD_Files/ScottoCaps/Flat/Legends/Greater.3mf
Gremlin_v3/CAD_Files/ScottoCaps/Flat/Legends/H.3mf
Gremlin_v3/CAD_Files/ScottoCaps/Flat/Legends/Hexagon.3mf
Gremlin_v3/CAD_Files/ScottoCaps/Flat/Legends/J.3mf
Gremlin_v3/CAD_Files/ScottoCaps/Flat/Legends/K.3mf
Gremlin_v3/CAD_Files/ScottoCaps/Flat/Legends/Left.3mf
Gremlin_v3/CAD_Files/ScottoCaps/Flat/Legends/Less.3mf
Gremlin_v3/CAD_Files/ScottoCaps/Flat/Legends/M.3mf
Gremlin_v3/CAD_Files/ScottoCaps/Flat/Legends/Minus.3mf
Gremlin_v3/CAD_Files/ScottoCaps/Flat/Legends/No (1.50u).3mf
Gremlin_v3/CAD_Files/ScottoCaps/Flat/Legends/O.3mf
Gremlin_v3/CAD_Files/ScottoCaps/Flat/Legends/P.3mf
Gremlin_v3/CAD_Files/ScottoCaps/Flat/Legends/Q.3mf
Gremlin_v3/CAD_Files/ScottoCaps/Flat/Legends/Question.3mf
Gremlin_v3/CAD_Files/ScottoCaps/Flat/Legends/Quote.3mf
Gremlin_v3/CAD_Files/ScottoCaps/Flat/Legends/R.3mf
Gremlin_v3/CAD_Files/ScottoCaps/Flat/Legends/RShift.3mf
Gremlin_v3/CAD_Files/ScottoCaps/Flat/Legends/Right.3mf
Gremlin_v3/CAD_Files/ScottoCaps/Flat/Legends/S.3mf
Gremlin_v3/CAD_Files/ScottoCaps/Flat/Legends/Semicolon.3mf
Gremlin_v3/CAD_Files/ScottoCaps/Flat/Legends/Shift (1.50u).3mf
Gremlin_v3/CAD_Files/ScottoCaps/Flat/Legends/Slash.3mf
Gremlin_v3/CAD_Files/ScottoCaps/Flat/Legends/Square.3mf
Gremlin_v3/CAD_Files/ScottoCaps/Flat/Legends/T.3mf
Gremlin_v3/CAD_Files/ScottoCaps/Flat/Legends/Tab (1.50u).3mf
Gremlin_v3/CAD_Files/ScottoCaps/Flat/Legends/Tab.3mf
Gremlin_v3/CAD_Files/ScottoCaps/Flat/Legends/Tilde.3mf
Gremlin_v3/CAD_Files/ScottoCaps/Flat/Legends/Triangle.3mf
Gremlin_v3/CAD_Files/ScottoCaps/Flat/Legends/U.3mf
Gremlin_v3/CAD_Files/ScottoCaps/Flat/Legends/Up.3mf
Gremlin_v3/CAD_Files/ScottoCaps/Flat/Legends/V.3mf
Gremlin_v3/CAD_Files/ScottoCaps/Flat/Legends/X.3mf
Gremlin_v3/CAD_Files/ScottoCaps/Flat/Legends/Yes (1.50u).3mf
Gremlin_v3/CAD_Files/ScottoCaps/Flat/Legends/Z.3mf
Gremlin_v3/CAD_Files/ScottoCaps/Glass/Choc/ScottoCaps (Glass) - 1.00u.stl
Gremlin_v3/CAD_Files/ScottoCaps/Glass/Choc/ScottoCaps (Glass) - 1.25u.stl
Gremlin_v3/CAD_Files/ScottoCaps/Glass/Choc/ScottoCaps (Glass) - 1.50u.stl
Gremlin_v3/CAD_Files/ScottoCaps/Glass/Choc/ScottoCaps (Glass) - 1.75u.stl
Gremlin_v3/CAD_Files/ScottoCaps/Glass/MX/ScottoCaps (Glass) - 1.00u.stl
Gremlin_v3/CAD_Files/ScottoCaps/Glass/MX/ScottoCaps (Glass) - 1.25u.stl
Gremlin_v3/CAD_Files/ScottoCaps/Glass/MX/ScottoCaps (Glass) - 1.75u.stl
Gremlin_v3/CAD_Files/ScottoCaps/Glass/MX/ScottoCaps (Glass) - 10.00u.stl
Gremlin_v3/CAD_Files/ScottoCaps/Glass/MX/ScottoCaps (Glass) - 2.00u.stl
Gremlin_v3/CAD_Files/ScottoCaps/Glass/MX/ScottoCaps (Glass) - 2.25u.stl
Gremlin_v3/CAD_Files/ScottoCaps/Glass/MX/ScottoCaps (Glass) - 2.50u.stl
Gremlin_v3/CAD_Files/ScottoCaps/Glass/MX/ScottoCaps (Glass) - 2.75u.stl
Gremlin_v3/CAD_Files/ScottoCaps/Glass/MX/ScottoCaps (Glass) - 3.00u.step
Gremlin_v3/CAD_Files/ScottoCaps/Glass/MX/ScottoCaps (Glass) - 3.00u.stl
Gremlin_v3/CAD_Files/ScottoCaps/Glass/MX/ScottoCaps (Glass) - 6.25u.stl
Gremlin_v3/CAD_Files/ScottoCaps/Glass/MX/ScottoCaps (Glass) - 7.00u.step
Gremlin_v3/CAD_Files/ScottoCaps/Glass/MX/ScottoCaps (Glass) - 7.00u.stl
Gremlin_v3/CAD_Files/ScottoCaps/Scooped/Choc/Blanks/16x16/1.00u (16x16 - Concave).stl
Gremlin_v3/CAD_Files/ScottoCaps/Scooped/Choc/Blanks/16x16/1.00u (16x16 - Convex).stl
Gremlin_v3/CAD_Files/ScottoCaps/Scooped/Choc/Blanks/16x16/1.00u (16x16 - Domed - Concave).stl
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
