AmazingSpanoMan/Gremlin_Gamepad/Gremlin_v3/KiCad/Gremlin_v3/production/UV_Printer_Graphics/Gremlin_v3_Top_Print.pdf

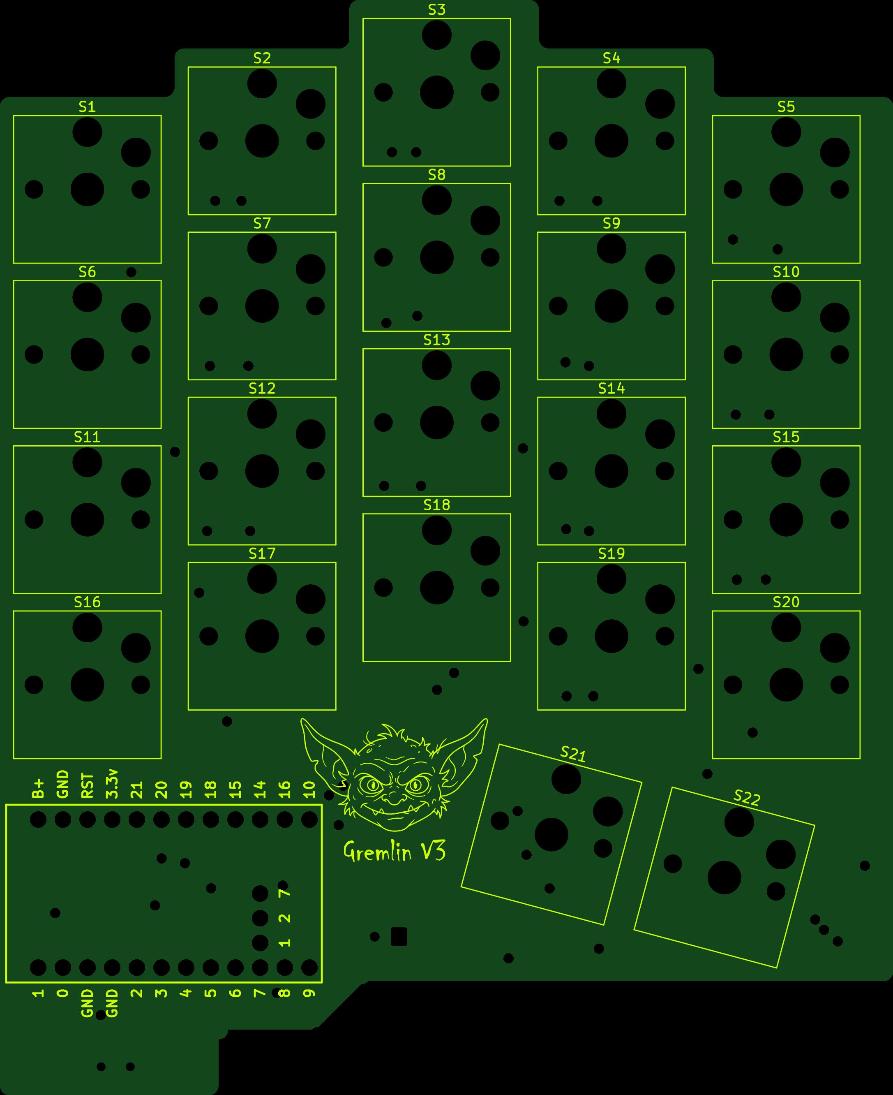
[picture p122: page 1]
