AmazingSpanoMan/Gremlin_Gamepad/Gremlin_v3/KiCad/Gremlin_v3/production/UV_Printer_Graphics/Gremlin_v3_Bottom_Silkscreen_1200dpi.png

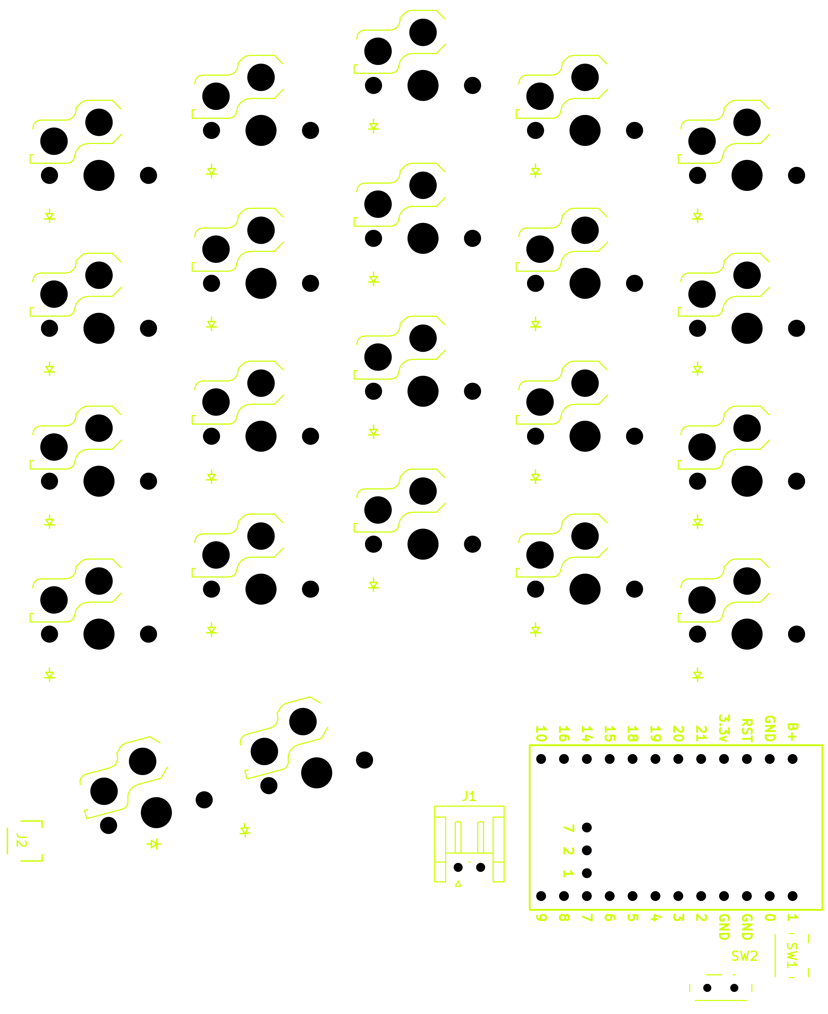
Gremlin_v3/KiCad/Gremlin_v3/production/UV_Printer_Graphics/Gremlin_v3_Bottom_Silkscreen_1200dpi.png
