AmazingSpanoMan/Gremlin_Gamepad/Gremlin_v3/KiCad/Gremlin_v3/Gremlin_v3.kicad_pcb

## KiCad design Gremlin_v3/KiCad/Gremlin_v3/Gremlin_v3.kicad_pcb (2026-11-11)

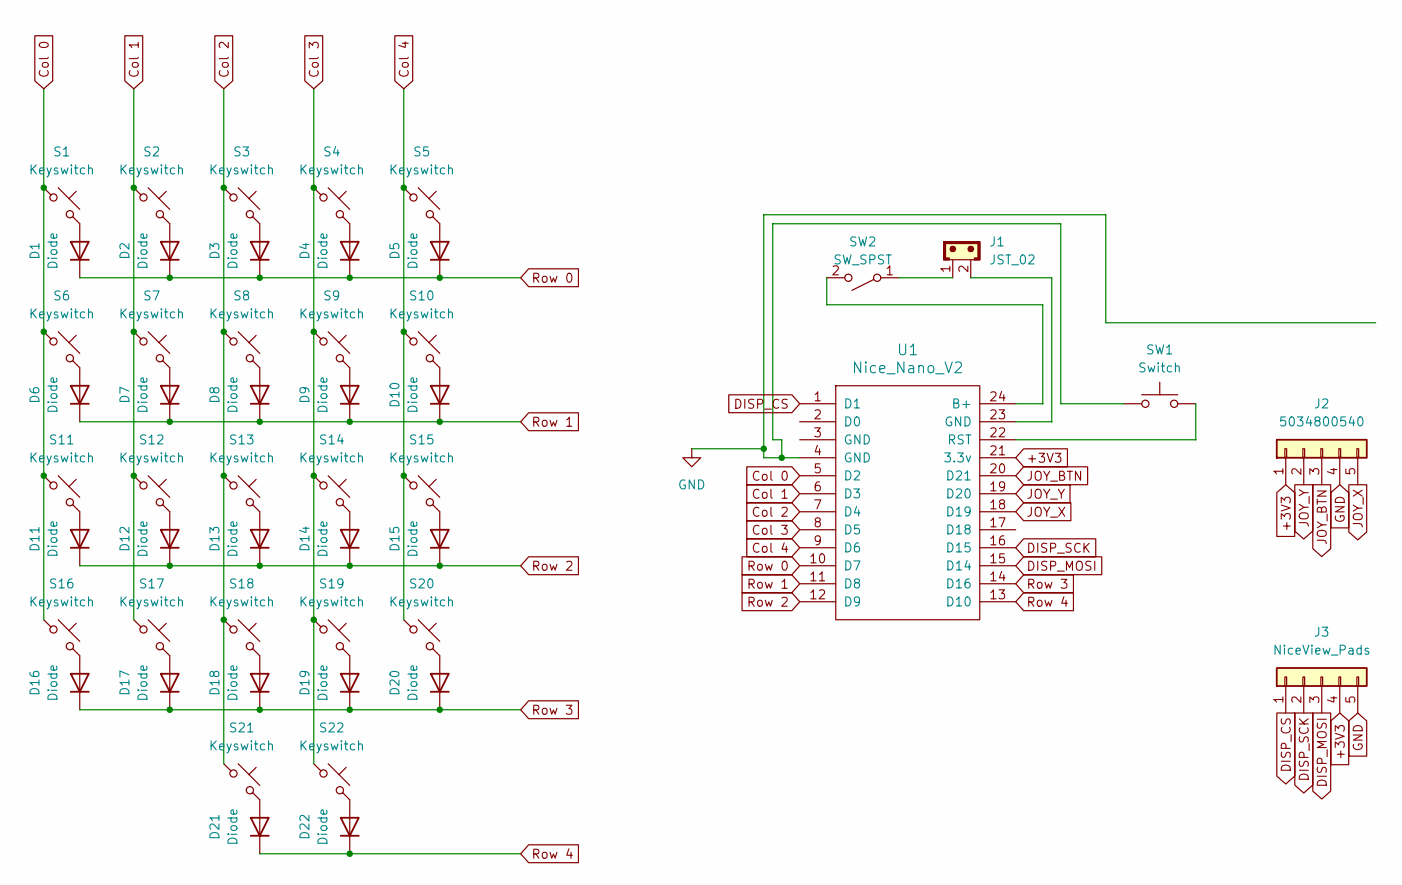
[picture p128: schematic Gremlin_v3.kicad_sch, Gremlin v3]

Parts:
D1, D2, D3, D4, D5, D6, D7, D8, D9, D10, D11, D12, D13, D14, D15, D16, D17, D18, D19, D20, D21, D22: Diode; Diode_SOD-123
J1: JST_02; JST_EH_S2B-EH_1x02_P2.50mm_Horizontal
J2: 5034800540; CONN_503480-0540_MOL
J3: NiceView_Pads; PinHeader_1x05_P2.54mm_Vertical
S1, S2, S3, S4, S5, S6, S7, S8, S9, S10, S11, S12, S13, S14, S15, S16, S17, S18, S19, S20, S21, S22: Keyswitch; Hotswap_Choc_V1
SW1: Switch; Panasonic_EVQPUJ_EVQPUA
SW2: SW_SPST; SW_SPDT_PCM12
U1: Nice_Nano_V2

Connections:
+3V3: J2.1, J3.4, U1.21 (3.3v)
Col 0: S1.1, S6.1, S11.1, S16.1, U1.5 (D2)
Col 1: S2.1, S7.1, S12.1, S17.1, U1.6 (D3)
Col 2: S3.1, S8.1, S13.1, S18.1, S21.1, U1.7 (D4)
Col 3: S4.1, S9.1, S14.1, S19.1, S22.1, U1.8 (D5)
Col 4: S5.1, S10.1, S15.1, S20.1, U1.9 (D6)
DISP_CS: J3.1, U1.1 (D1)
DISP_MOSI: J3.3, U1.15 (D14)
DISP_SCK: J3.2, U1.16 (D15)
GND: J2.4, J3.5, SW1.1, U1.4 (GND)
JOY_BTN: J2.3, U1.20 (D21)
JOY_X: J2.5, U1.18 (D19)
JOY_Y: J2.2, U1.19 (D20)
unnamed: D1.2 (A), S1.2
unnamed: D2.2 (A), S2.2
unnamed: D3.2 (A), S3.2
unnamed: D4.2 (A), S4.2
unnamed: D5.2 (A), S5.2
unnamed: D6.2 (A), S6.2
unnamed: D7.2 (A), S7.2
unnamed: D8.2 (A), S8.2
unnamed: D9.2 (A), S9.2
unnamed: D10.2 (A), S10.2
unnamed: D11.2 (A), S11.2
unnamed: D12.2 (A), S12.2
unnamed: D13.2 (A), S13.2
unnamed: D14.2 (A), S14.2
unnamed: D15.2 (A), S15.2
unnamed: D16.2 (A), S16.2
unnamed: D17.2 (A), S17.2
unnamed: D18.2 (A), S18.2
unnamed: D19.2 (A), S19.2
unnamed: D20.2 (A), S20.2
unnamed: D21.2 (A), S21.2
unnamed: D22.2 (A), S22.2
unnamed: J1.2, U1.23 (GND)
unnamed: J1.1, SW2.1 (A)
unnamed: SW2.2 (B), U1.24 (B+)
unnamed: SW1.2, U1.22 (RST)
Row 0: D1.1 (K), D2.1 (K), D3.1 (K), D4.1 (K), D5.1 (K), U1.10 (D7)
Row 1: D6.1 (K), D7.1 (K), D8.1 (K), D9.1 (K), D10.1 (K), U1.11 (D8)
Row 2: D11.1 (K), D12.1 (K), D13.1 (K), D14.1 (K), D15.1 (K), U1.12 (D9)
Row 3: D16.1 (K), D17.1 (K), D18.1 (K), D19.1 (K), D20.1 (K), U1.14 (D16)
Row 4: D21.1 (K), D22.1 (K), U1.13 (D10)

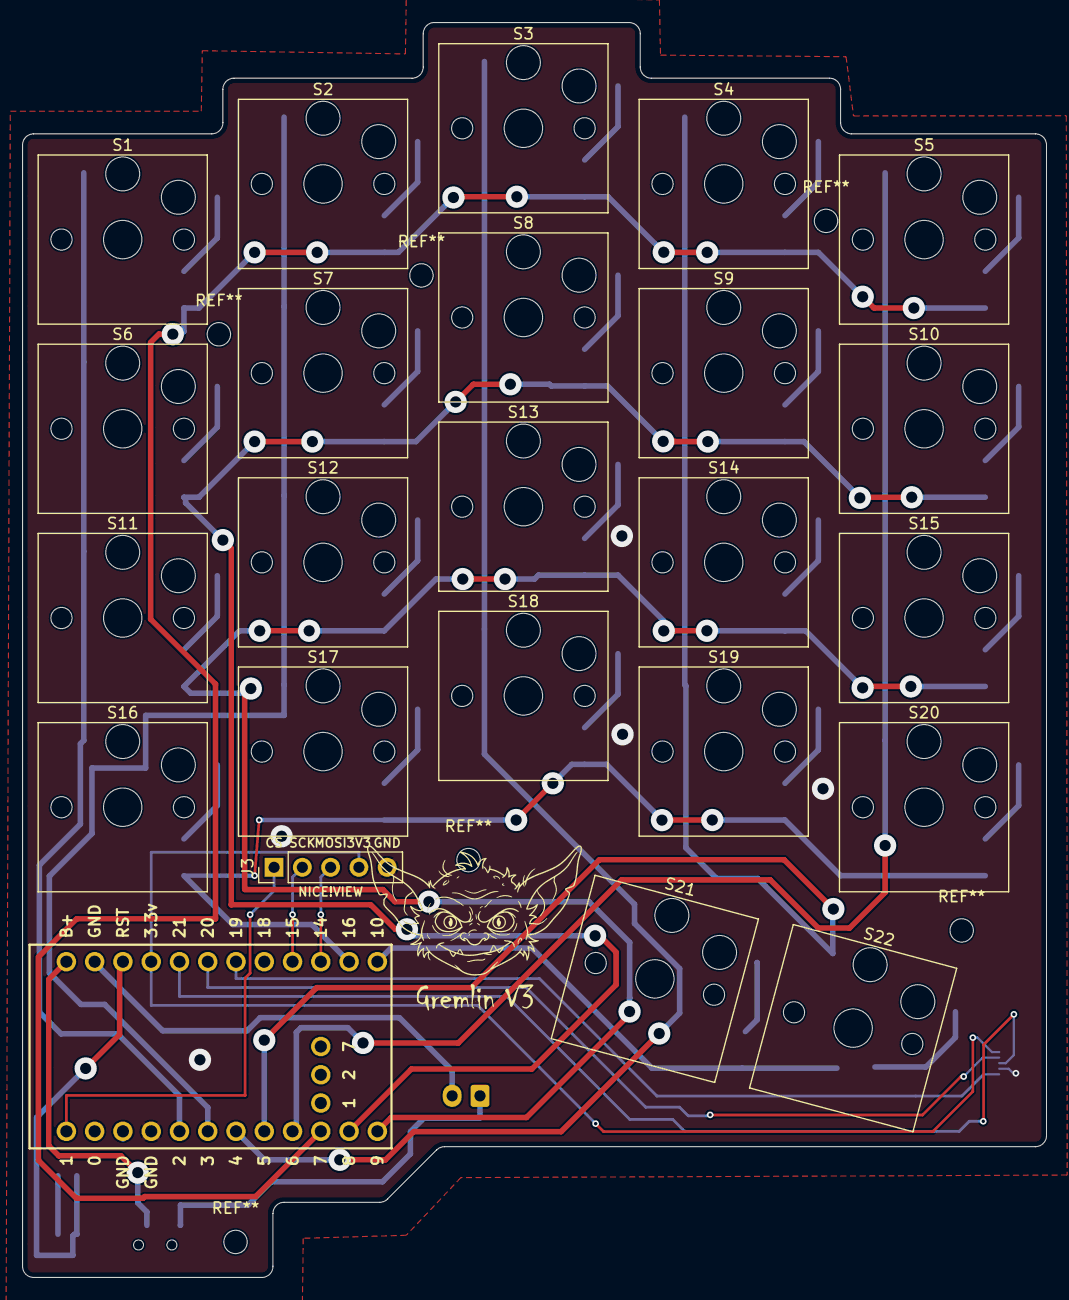
[picture p129: board Gremlin_v3.kicad_pcb from above]

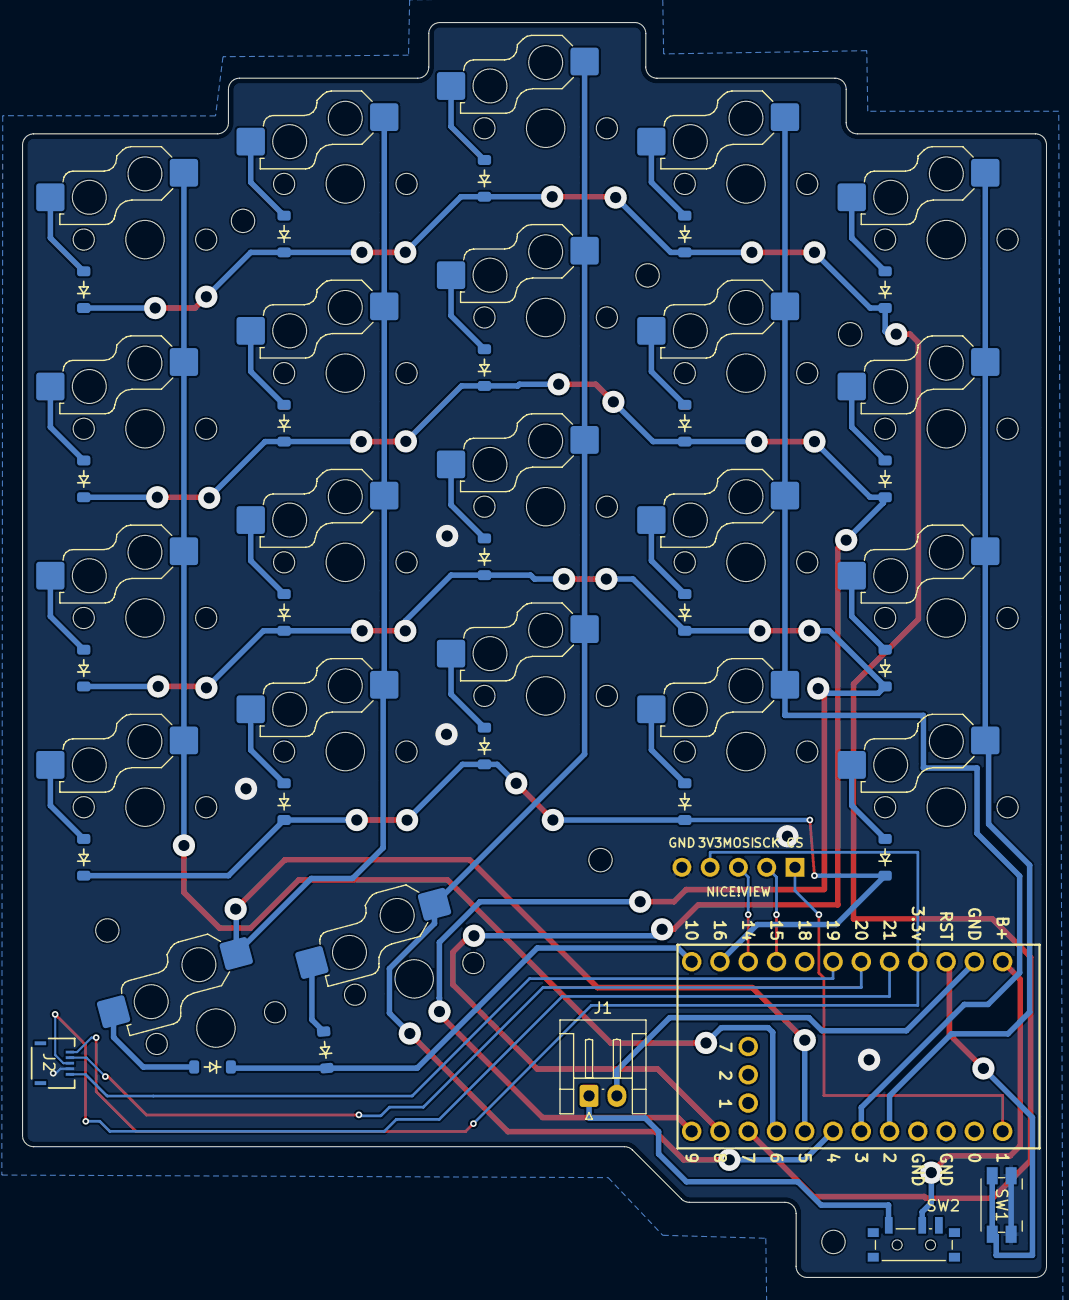
[picture p130: board Gremlin_v3.kicad_pcb from below]

Board: 2 copper layers, 92.0 x 112.8 mm, 50 parts (26 on the bottom side), 44 nets.
