AmazingSpanoMan/Gremlin_Gamepad/Gremlin_v2/KiCad Files/Nav Switch Mount (1-sided)/Nav Switch Mount.kicad_pcb

## KiCad design Gremlin_v2/KiCad Files/Nav Switch Mount (1-sided)/Nav Switch Mount.kicad_pcb (2026-10-09, an earlier design)

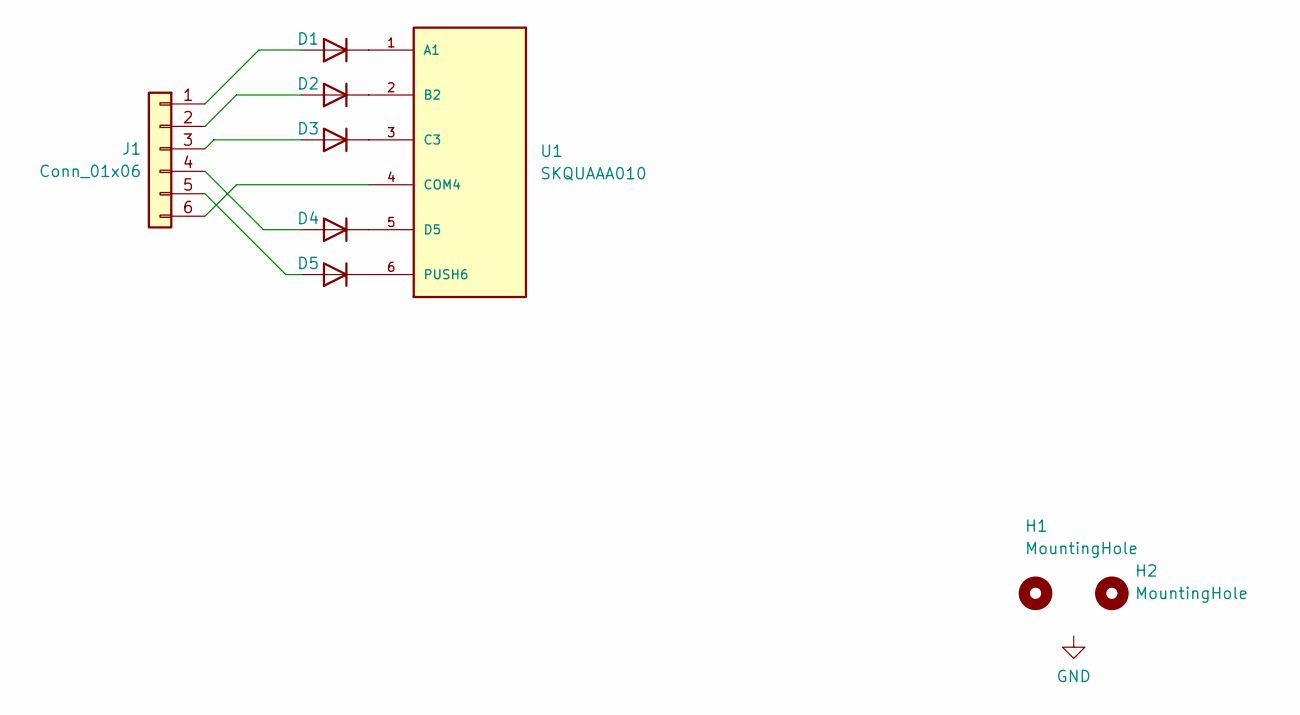
[picture p131: schematic Nav Switch Mount.kicad_sch]

Parts:
D1, D2, D3, D4, D5: D; D_SOD-123
H1, H2: MountingHole; MountingHole_2.1mm
J1: Conn_01x06; Header_2x3
U1: SKQUAAA010; Nav_Switch_SKQUAAA010

Connections:
unnamed: D1.2 (A), J1.1
unnamed: D1.1 (K), U1.1 (A1)
unnamed: D2.2 (A), J1.2
unnamed: D2.1 (K), U1.2 (B2)
unnamed: D3.2 (A), J1.3
unnamed: D3.1 (K), U1.3 (C3)
unnamed: D4.2 (A), J1.4
unnamed: D4.1 (K), U1.5 (D5)
unnamed: D5.2 (A), J1.5
unnamed: D5.1 (K), U1.6 (PUSH6)
unnamed: J1.6, U1.4 (COM4)

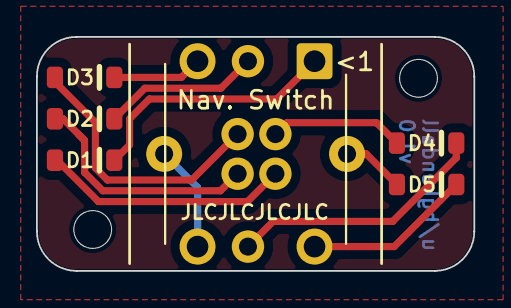
[picture p132: board Nav Switch Mount.kicad_pcb from above]

Board: 2 copper layers, 24.3 x 13.0 mm, 9 parts (1 on the bottom side), 11 nets.
