AmazingSpanoMan/Gremlin_Gamepad/(commit log)

2026-10-09 Organization Changes
    [Gremlin_v2.kicad_pcb, Gremlin_v2.kicad_sch, Gremlin_v2.step, JS1400AFQ.step, JS5208.step, Joystick.step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]
2026-10-09 Added Joystick
    [Switch JoyCon joystick v2.step]
2026-10-09 Initial KiCad files
    [Gremlin_v3.kicad_pcb, Gremlin_v3.kicad_sch]
2026-10-09 Added Scotto Keebs Libraries
    [0 (1.00u).3mf, 0 (16x16).3mf, 0 (18x17).3mf, 0 (18x18).3mf, 0 (2.00u).3mf, 0.3mf, 1 (16x16).3mf, 1 (18x17).3mf]
2026-10-09 Update KiCad Design
    [FPC-5.stp, Gremlin_v3.kicad_pcb, Gremlin_v3.kicad_sch]
2026-10-09 3d model for case design
    [Gremlin_v3.kicad_pcb, Gremlin_v3.step]
2026-10-14 pcb updates
2026-10-14 pcb design updates
2026-10-16 Kicad update
2026-10-18 Updated PCB design for CNC Milling
2026-10-21 udpated pcb for cnc
2026-10-21 updated PCB for better trace creation using a cnc
2026-10-21 larger traces and adjustments
2026-10-22 Updated pcb again
2026-10-22 Via Holes
    Fixed Vias to the correct hole size. Adjusted vias and traces that were affected by the larger via size.
2026-10-23 Update board target to nice_nano//zmk for Zephyr HWMv2
2026-10-23 Fix kscan-composite direct node to use row-offset and remove deprecated config/boards
2026-10-23 Pin ZMK to stable v0.3 release for driver and studio compatibility
2026-10-23 Replace nrf-saadc header with adc.h and direct channel defines for Zephyr 3.5 compatibility
2026-10-24 feat(display): add menacing full-body gremlin mascot with claw slash and snarl animations
2026-10-24 feat(assembly): generate pick and place (CPL) and BOM files for SMT assembly
2026-10-25 case CAD UPDATE
2026-10-26 docs: add comprehensive Joy-Con joystick calibration and driver guide
2026-10-27 spring cleaning
2026-10-28 switched pins for screen
2026-10-29 Align display and mascot for vertical portrait mount with pins at bottom
2026-10-29 Configure Joy-Con stick click for active-high with pull-down (Hall Effect stick)
2026-10-29 update stl
2026-10-29 Fix key matrix diode direction (row2col) and calibrate analog stick deadzone/center
2026-10-29 Set diode direction to col2row and restore vertical 68x160 portrait display
2026-10-29 Set display to native 160x68 with 1MHz SPI and enable built-in status screen
2026-10-29 Remap matrix Col 2 to pro_micro 1 (P0.06 / Pin 1) for jumper wire
2026-10-29 Fix display driver resolution to 160x68 with razor-sharp 1:1 pixel rotated vertical layout and remap Col 2 to raw gpio0 6 (Pin 1)
2026-10-30 fix(matrix,display): restore Col 2 to native PCB pin 7 and fix status text rendering via True Color canvas
2026-10-30 fix(matrix): map Col 2 directly to raw gpio0 22 (Pin 7 / Silk 4)
2026-10-30 fix(matrix): remap Col 2 to Pin 1 (P0.06 / Silk 0) rescue pin
2026-10-30 feat(keymap): add Ctrl-number game layer and G+V multi-button system for BT/layer control
2026-10-30 fix(joystick): calibrate ADC channels and invert-x using live multimeter voltages
2026-10-30 fix(joystick): lower switch activation point to 28 and increase deadzone to 20%
2026-10-31 fix(joystick): calibrate analog stick to live hardware ADC values and throttle active polling to 10ms
2026-10-31 docs: update handover guide with live ADC calibration data and KiCad redesign plan
2026-10-31 fix(joystick): restore true Zephyr SAADC channel mappings (AIN5=5, AIN7=7) and 12-bit calibration
2026-10-31 PCB fixes
2026-10-31 Re-export JLCPCB production package (Gerbers, Drill, BOM, CPL) with latest PCB design adjustments
2026-11-10 fix(joystick): restore Nordic SAADC PSELP register values (AIN0=1, AIN5=6) and hardware calibration limits
2026-11-11 fix(pcb): mirror J2 Joy-Con pinout for bottom-contact FPC insertion and update production package
2026-11-12 fix(joystick): swap rotated XY ADC channels and calibrate 12-bit bounds from live hardware
2026-11-12 fix(studio,keymap): re-enable ZMK Studio USB RPC and restore Game layer switch (&to 0)
2026-11-12 fix(adc,ble): move joystick Y off SAADC ch0 and increase BLE/input stacks and TX buffers
2026-11-13 Update Power Switch Button.stl
2026-11-13 test(display): temporarily switch to ZMK built-in status screen
2026-11-13 debug(usb): enable zmk-usb-logging with display and SPI debug logs
2026-11-13 diag(display): test SPIM3 and add boot GPIO short/power diagnostic
2026-11-13 diag(display): run unconditional J3 electrical probe and slow GPIO bitbang LCD test
2026-11-13 diag(display): add NC pullup sanity, EXT_PWR active-low probe, and H0H1 pump test
